brennanMKE/TronCostume/cad/params.md

# Frame parameters (mm)

Source: docs/frame.md. Origin = disc center. Angles clockwise from 12 o'clock seen from the front.
Bay local coords: y along the bay's center line from the disc center, x sideways (+ = clockwise).

| Name | Value |
|---|---|
| Outer radius | 130 |
| Hand hole radius | 60 |
| Outer rim inner radius | 114 |
| Ply layers | 4 × 6 (layers 1-3 identical, layer 4 adds wire slots) |
| Covered bays | centers 60° (buttons), 300° (electronics) |
| Covered bay front part | \|x\| ≤ 53, from the hand hole to y = 84 |
| Covered bay rear part | \|x\| ≤ 39, from y = 84 to R114 |
| Block pockets | x = ±39…±53, y = 64…84 (blocks 14 × 20 × 24) |
| Cover | 106 × 23.5 × 3 black acrylic, at y = 61…64, holes Ø4.5 at x = ±46 |
| Battery bay | center 180°, \|x\| ≤ 45, y = 66…96 |
| Front inserts | R102 at 0°, 120°, 240° |
| Back inserts | R80 at 0°, 120°, 240° |
| Insert OD (marked) | 8 |
| Wire slots (layer 4) | R92…R100, 320°→40° and 205°→278° |
