brennanMKE/TronCostume/concepts/Exploded DIY Tron identity disc.png

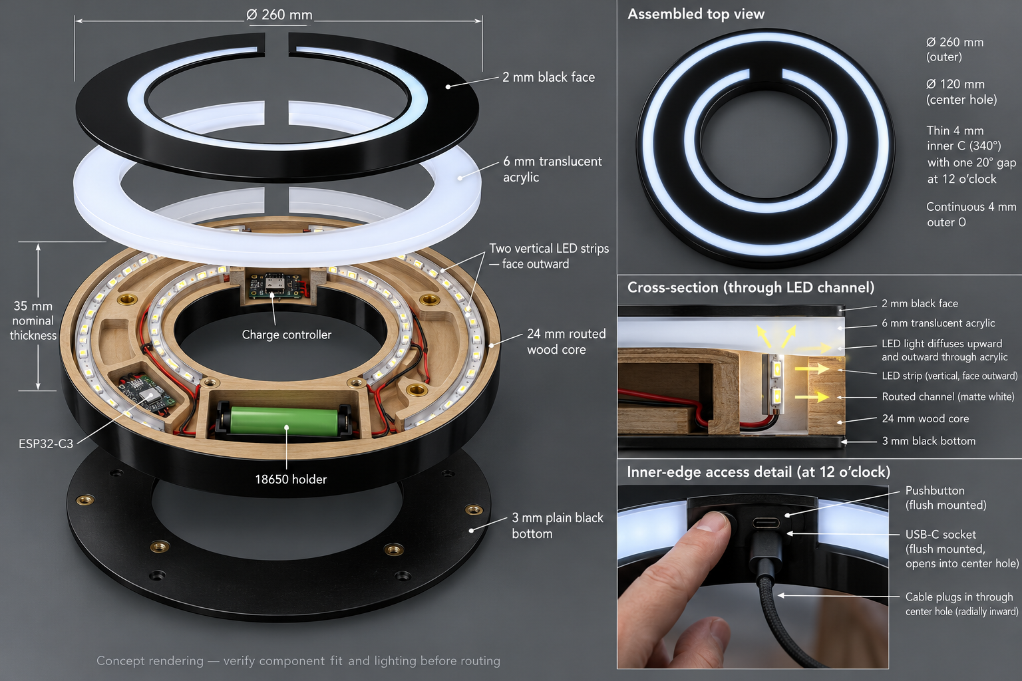
concepts/Exploded DIY Tron identity disc.png
