brennanMKE/TronCostume/concepts/Exploded vertical four-button plywood module.png

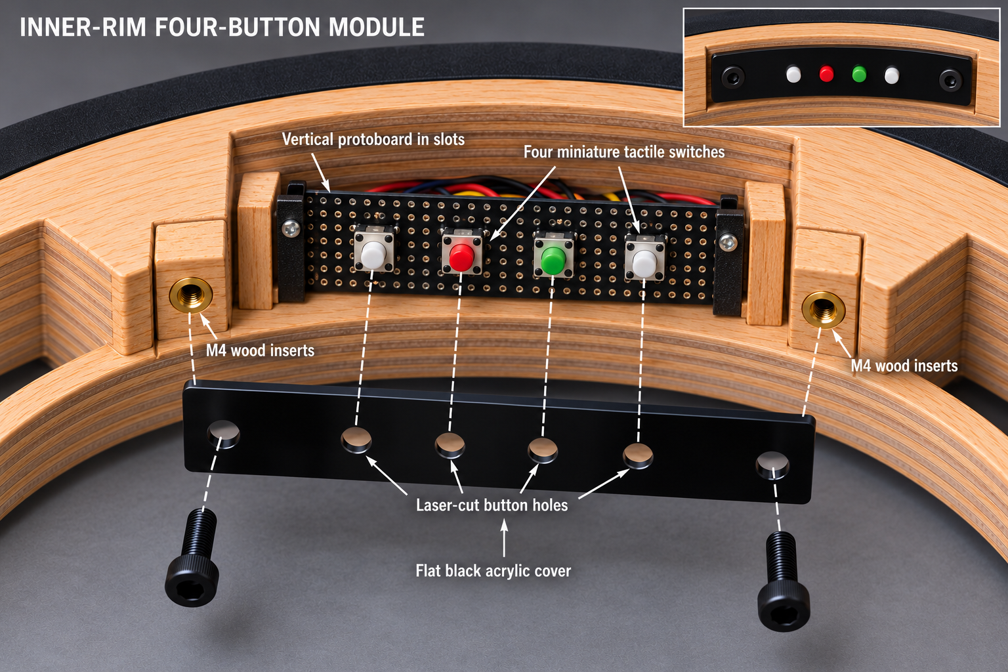
concepts/Exploded vertical four-button plywood module.png
