brennanMKE/TronCostume/concepts/Identity disc prototype.png

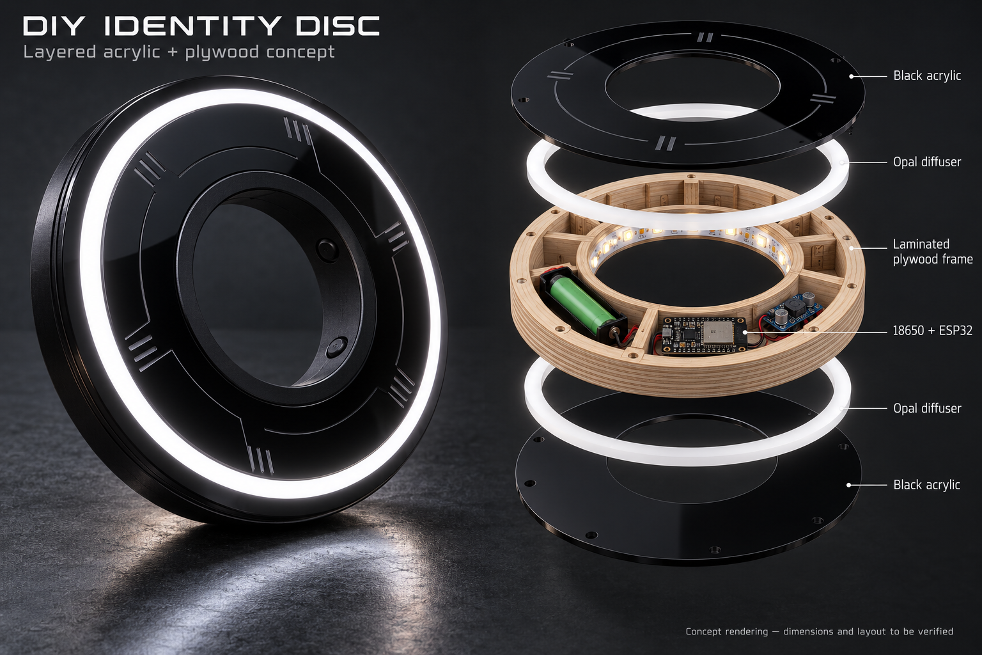
concepts/Identity disc prototype.png
