brennanMKE/TronCostume/concepts/Identity Disc.png

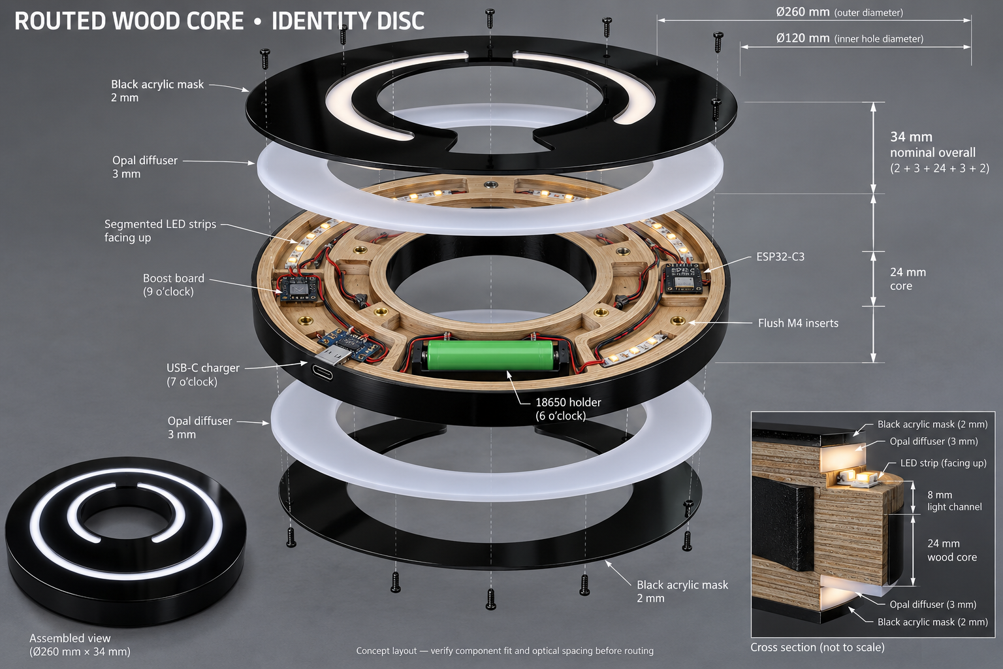
concepts/Identity Disc.png
