brennanMKE/TronCostume/concepts/Inner-rim electronics module.png

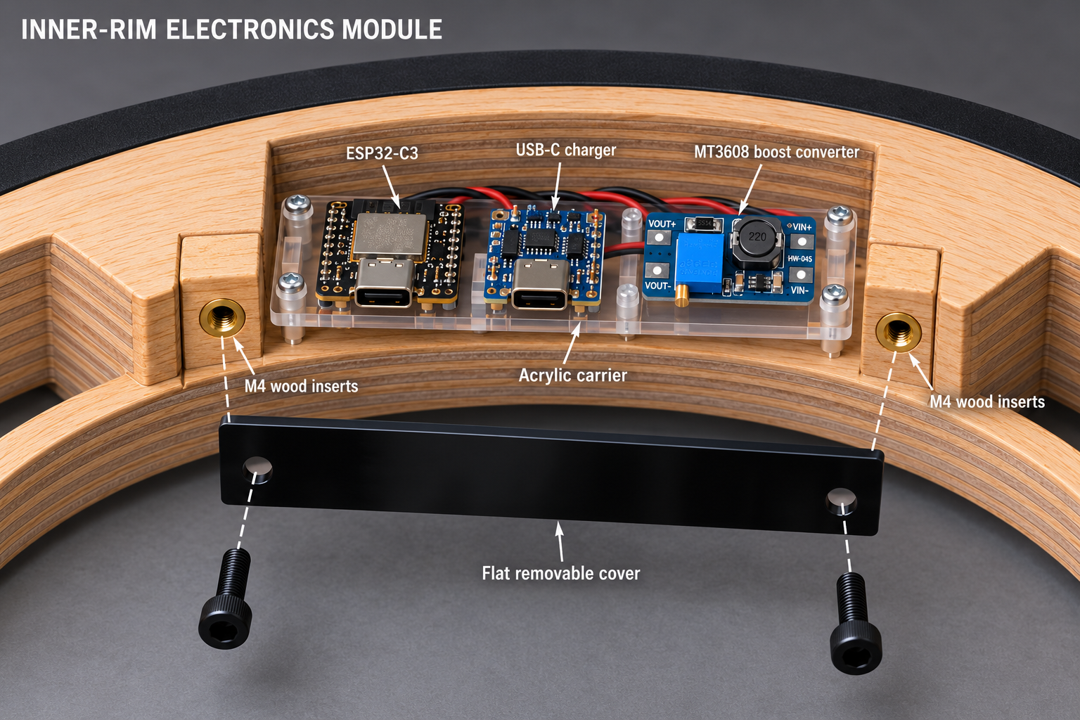
concepts/Inner-rim electronics module.png
