brennanMKE/TronCostume/concepts/Revised DIY Identity Disc Concept.png

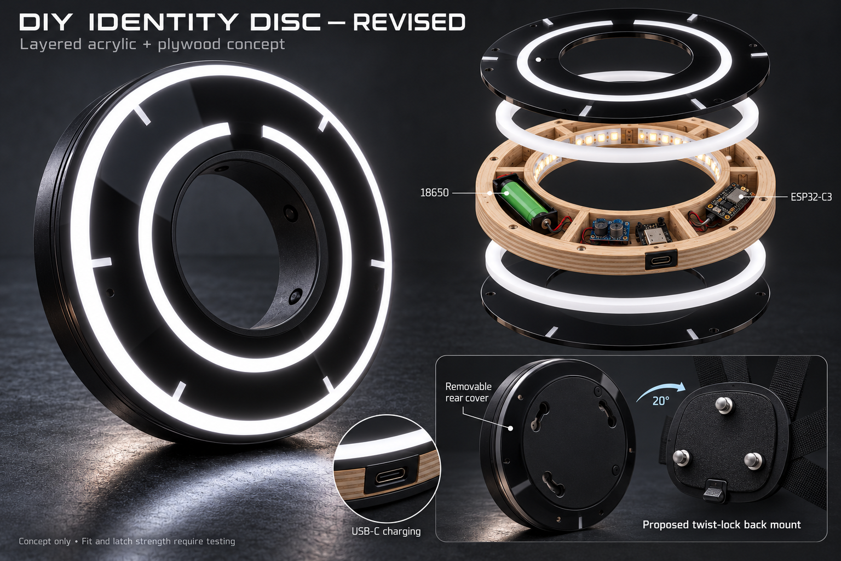
concepts/Revised DIY Identity Disc Concept.png
