brennanMKE/TronCostume/concepts/Three-bridge plywood annular frame.png

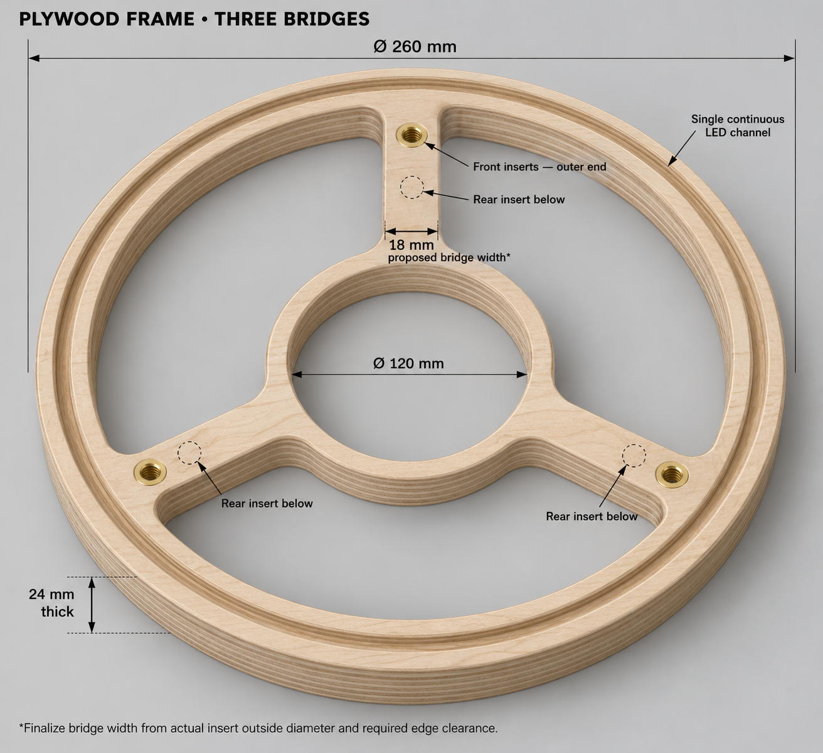
concepts/Three-bridge plywood annular frame.png
