brennanMKE/TronCostume/mockup/protoboard for buttons.png

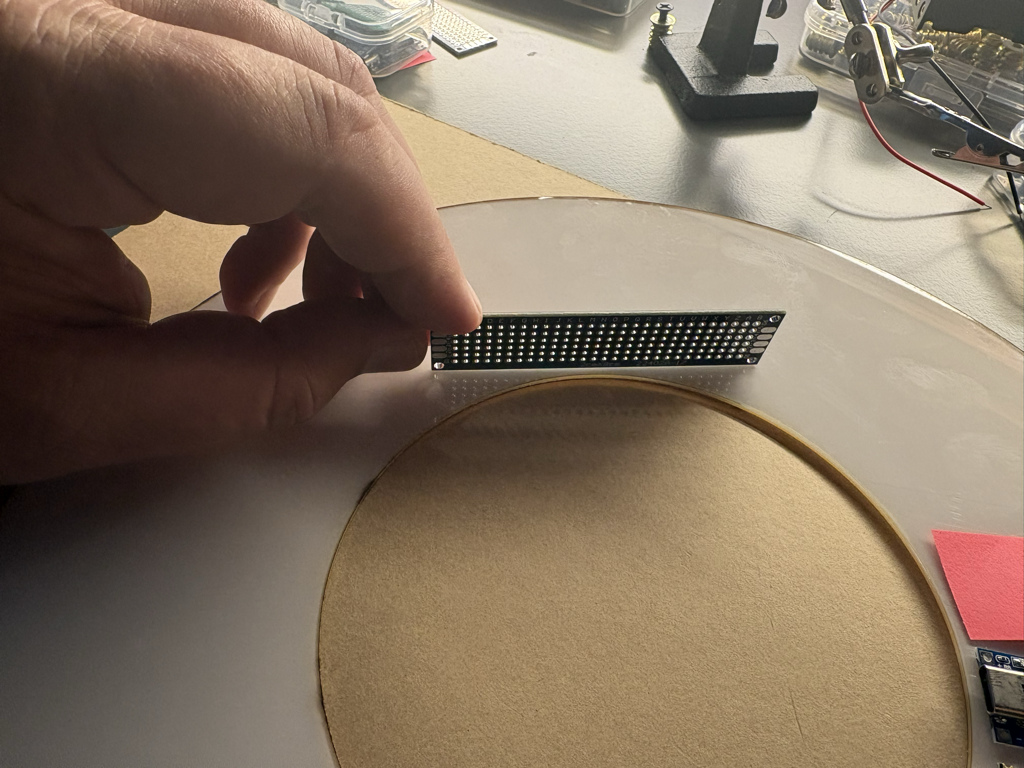
mockup/protoboard for buttons.png
