brennanMKE/TronCostume/build-plans/render/v4/PREVIEW-all-parts.png

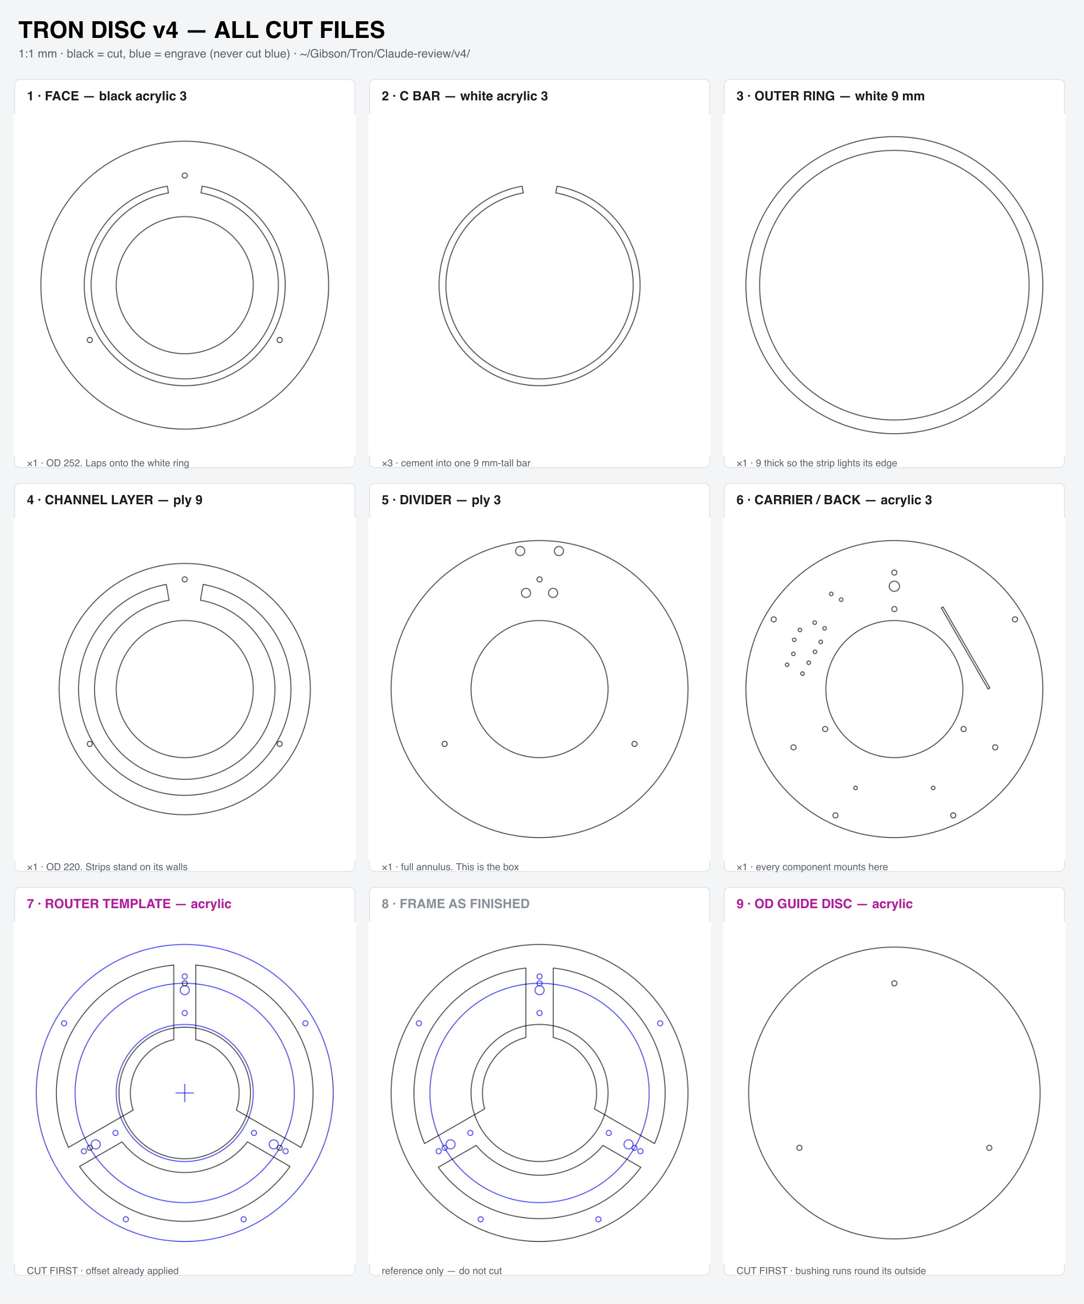
build-plans/render/v4/PREVIEW-all-parts.png
