brennanMKE/TronCostume/mockup/3 components.png

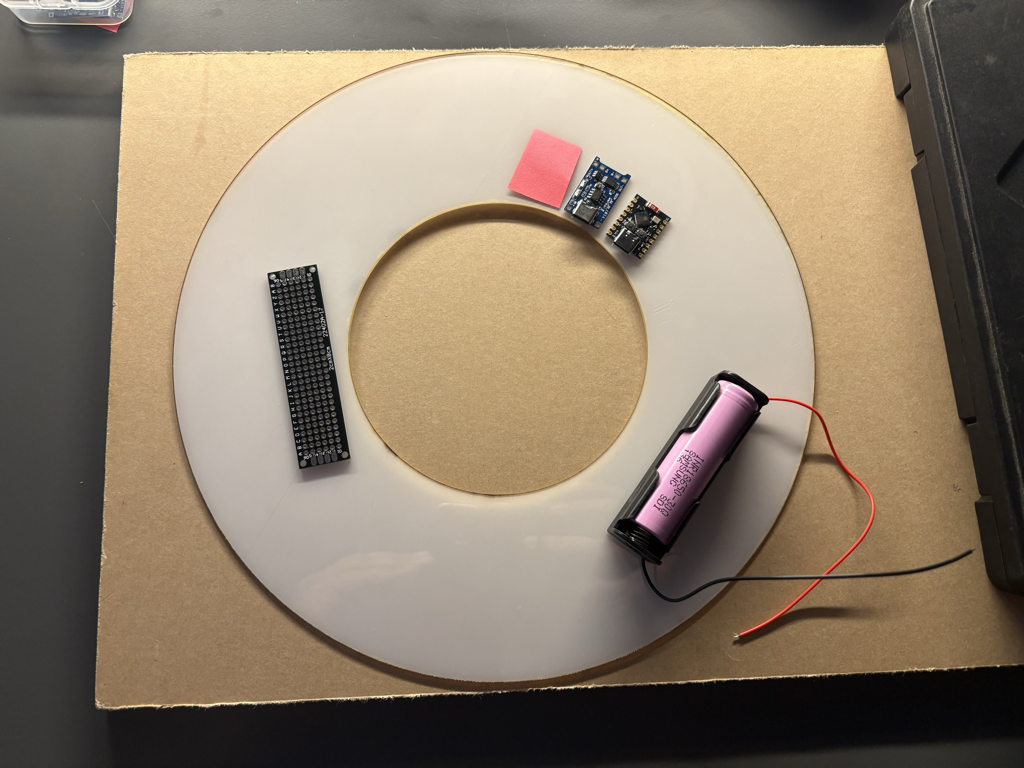
mockup/3 components.png
