brennanMKE/TronCostume/cad/v2/disc-v2-assembly.step

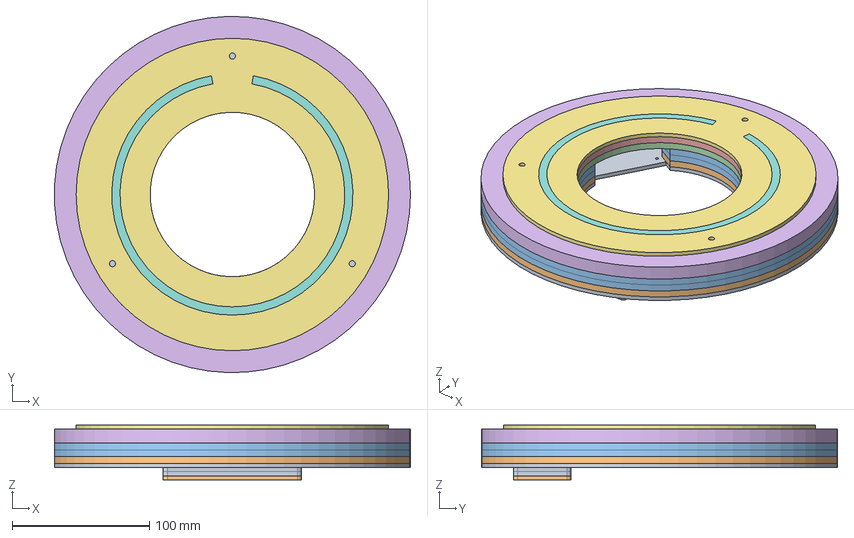
[picture p12: CAD file, 2026-11-05]
cad/v2/disc-v2-assembly.step
259.8 x 259.9 x 40.0 mm
