brennanMKE/TronCostume/cad/disc-assembly.step

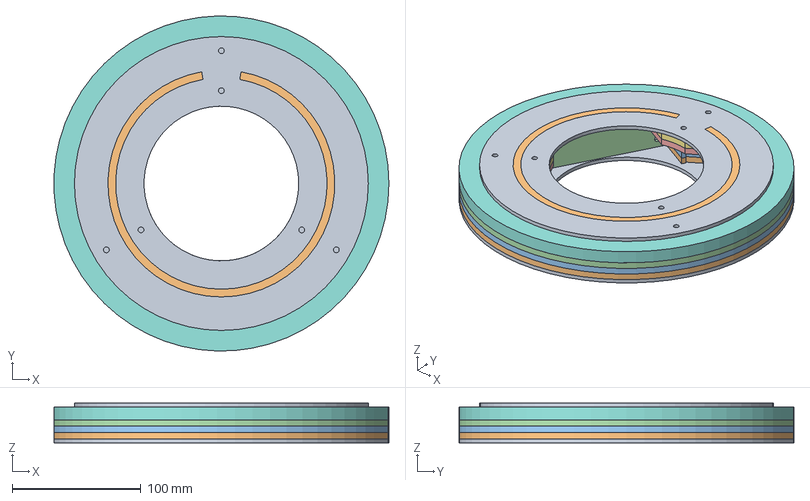
[picture p13: CAD file, 2026-11-05]
cad/disc-assembly.step
259.8 x 259.9 x 31.0 mm
