brennanMKE/TronCostume/cad/led-c-strip-reference.stl

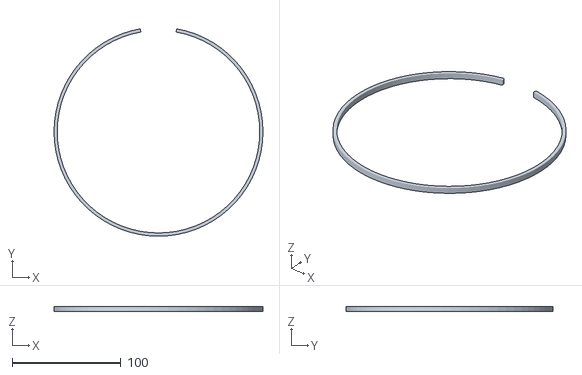
[picture p14: CAD file, 2026-11-05]
cad/led-c-strip-reference.stl
192.0 x 190.5 x 5.00
