brennanMKE/TronCostume/cad/out/frame.dxf

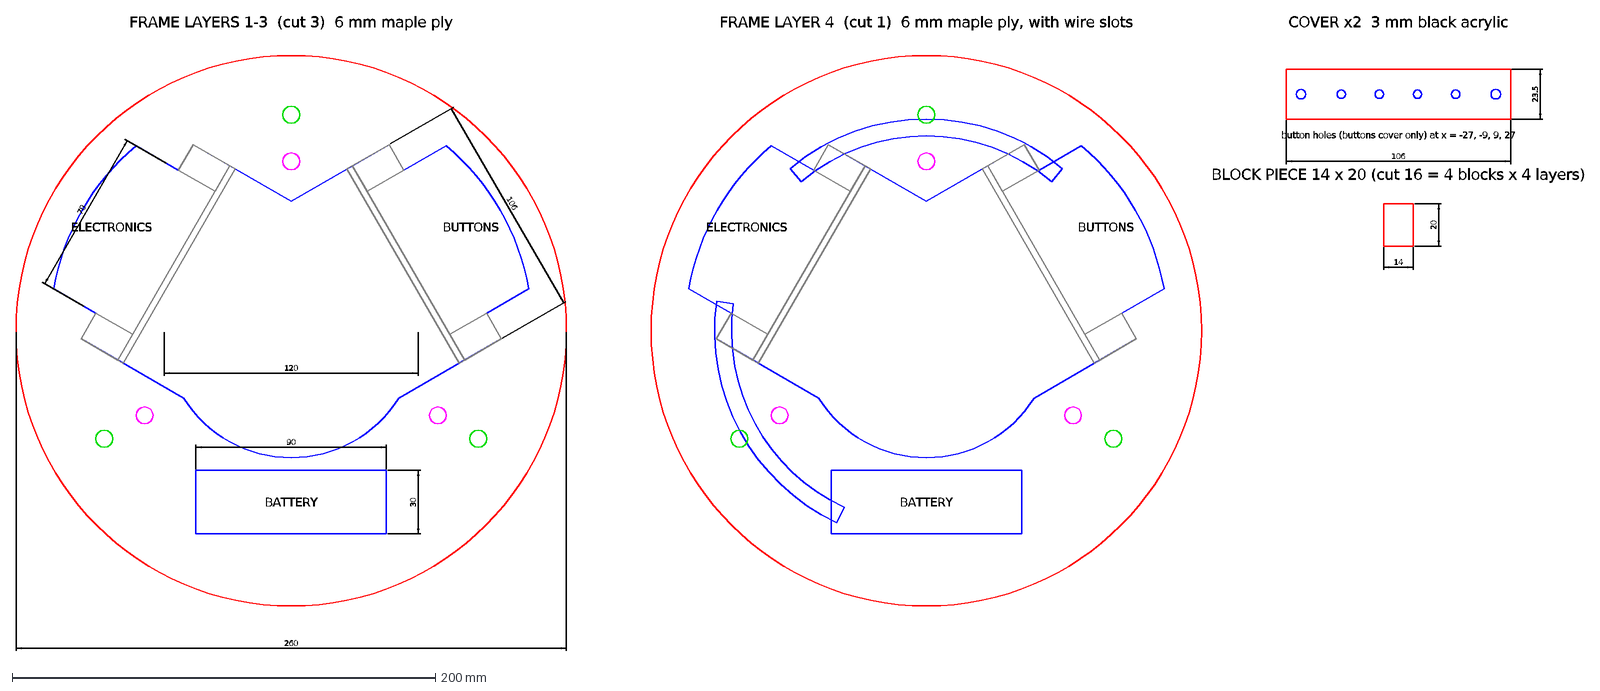
[picture p15: CAD file, 2026-10-30]
cad/out/frame.dxf
FRAME LAYERS 1-3 (cut 3) 6 mm maple ply
BUTTONS
ELECTRONICS
BATTERY
FRAME LAYER 4 (cut 1) 6 mm maple ply, with wire slots
COVER x2 3 mm black acrylic
button holes (buttons cover only) at x = -27, -9, 9, 27
BLOCK PIECE 14 x 20 (cut 16 = 4 blocks x 4 layers)
260
120
90
30
106
78
23.5
14
20
