brennanMKE/TronCostume/cad/v2/acrylic-3mm-black-back.dxf

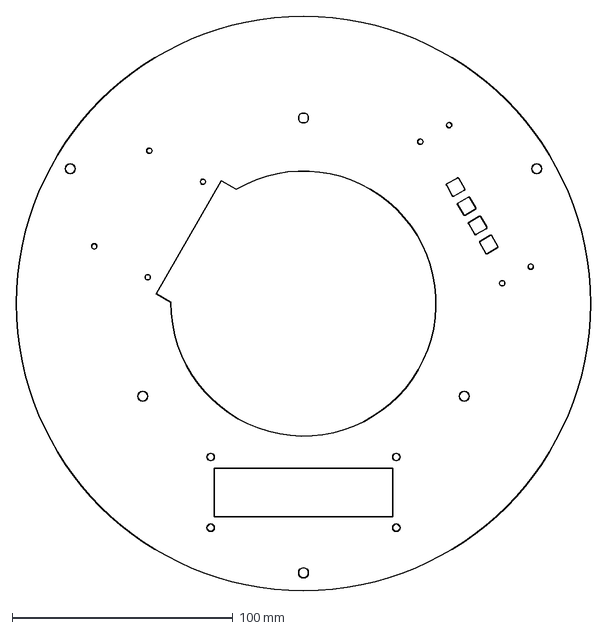
[picture p16: CAD file, 2026-11-05]
cad/v2/acrylic-3mm-black-back.dxf
260.0 x 260.0 mm
