brennanMKE/TronCostume/cad/v2/battery/stl/led_piece.stl

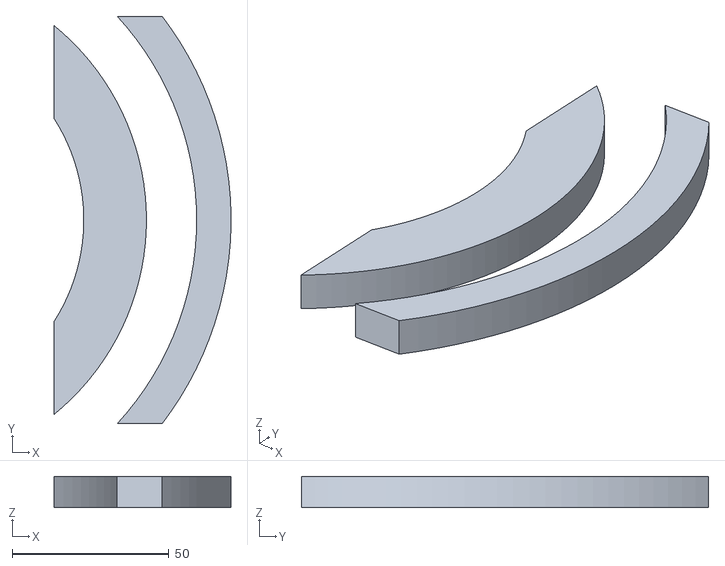
[picture p17: CAD file, 2026-11-05]
cad/v2/battery/stl/led_piece.stl
56.5 x 130.0 x 10.0
