brennanMKE/TronCostume/cad/v2/pod/stl/ics.stl

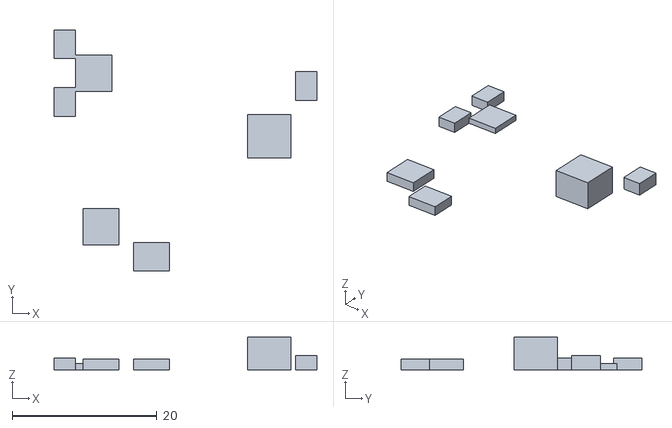
[picture p18: CAD file, 2026-11-05]
cad/v2/pod/stl/ics.stl
36.4 x 33.4 x 4.50
