brennanMKE/TronCostume/cad/v2/stl/inserts_ref.stl

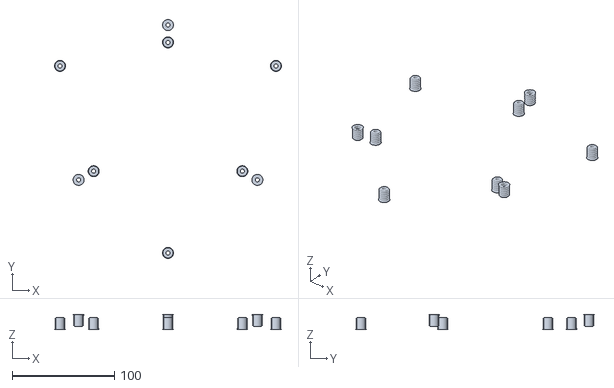
[picture p19: CAD file, 2026-11-05]
cad/v2/stl/inserts_ref.stl
222.1 x 233.8 x 15.0
