brennanMKE/TronCostume/cad/led-connector-reference.stl

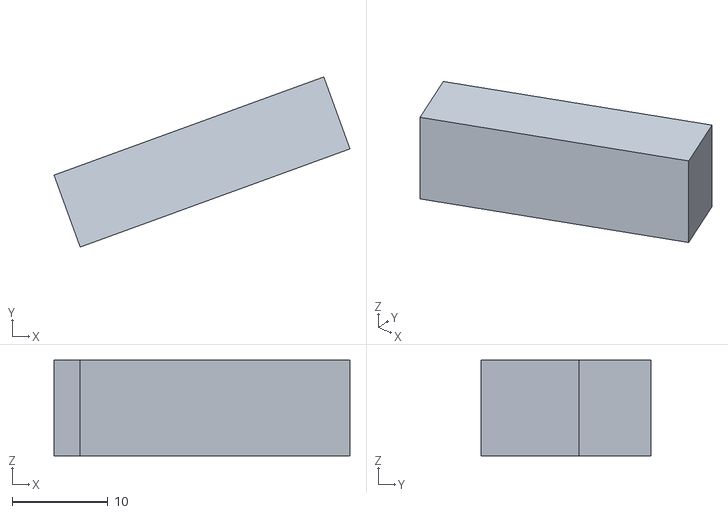
[picture p20: CAD file, 2026-11-05]
cad/led-connector-reference.stl
30.9 x 17.8 x 10.0
