brennanMKE/TronCostume/cad/v2/pod/stl/led_piece.stl

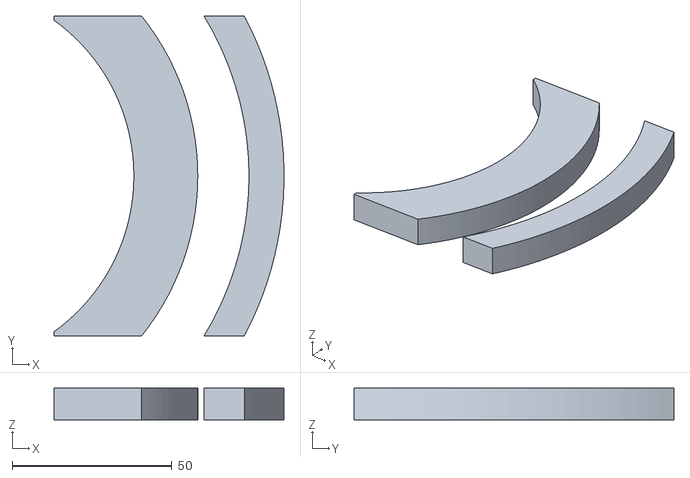
[picture p21: CAD file, 2026-11-05]
cad/v2/pod/stl/led_piece.stl
72.0 x 100.0 x 10.0
