brennanMKE/TronCostume/cad/v2/stl/led_jumper.stl

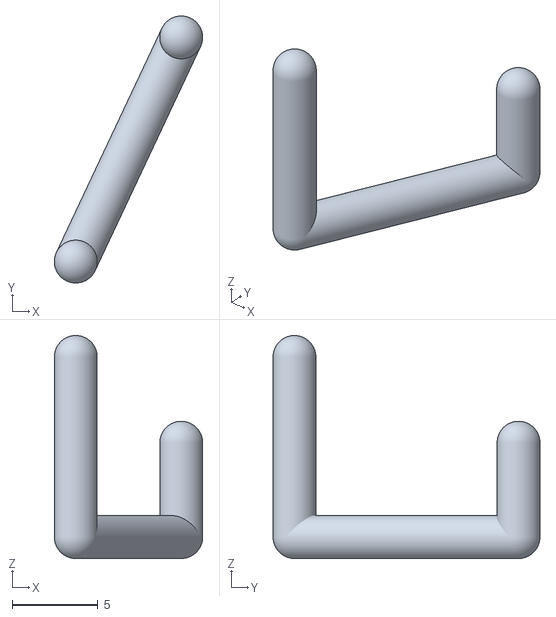
[picture p22: CAD file, 2026-11-05]
cad/v2/stl/led_jumper.stl
8.65 x 15.6 x 13.0
