brennanMKE/TronCostume/cad/acrylic-10mm-white-outer-ring.step

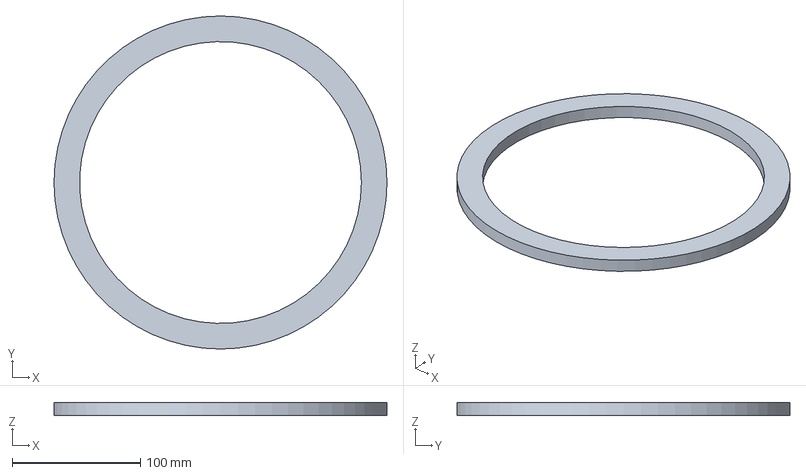
[picture p23: CAD file, 2026-11-05]
cad/acrylic-10mm-white-outer-ring.step
260.0 x 260.0 x 10.0 mm
