brennanMKE/TronCostume/cad/v2/acrylic-3mm-black-battery-box-floor.dxf

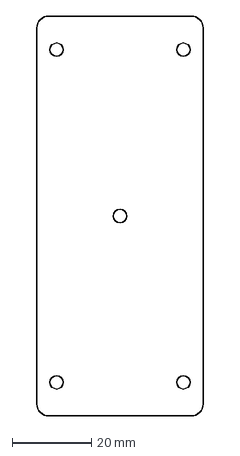
[picture p24: CAD file, 2026-11-05]
cad/v2/acrylic-3mm-black-battery-box-floor.dxf
42.0 x 101.0 mm
