brennanMKE/TronCostume/cad/v2/battery/stl/ring2.stl

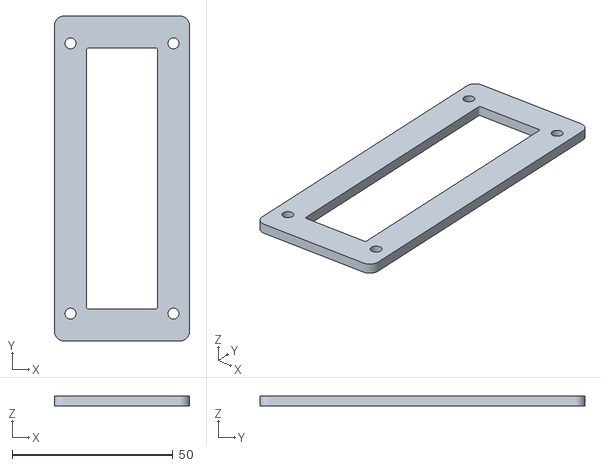
[picture p25: CAD file, 2026-11-05]
cad/v2/battery/stl/ring2.stl
42.0 x 101.0 x 3.00
