brennanMKE/TronCostume/cad/v2/pod/stl/locator.stl

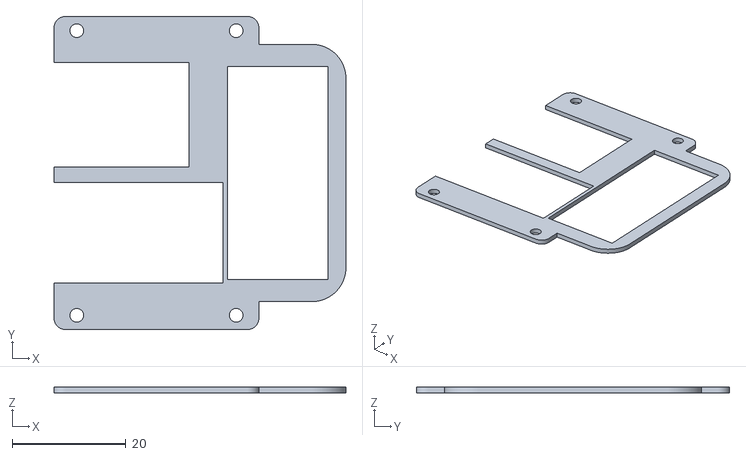
[picture p26: CAD file, 2026-11-05]
cad/v2/pod/stl/locator.stl
51.3 x 55.0 x 1.00
