brennanMKE/TronCostume/cad/disc-lid.step

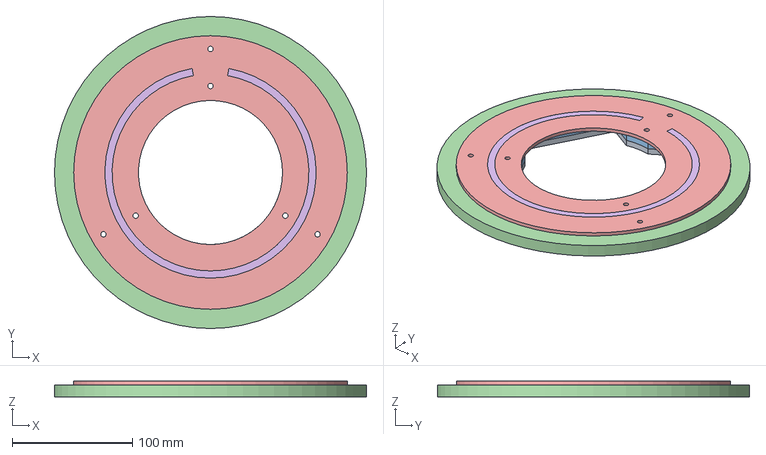
[picture p27: CAD file, 2026-11-05]
cad/disc-lid.step
260.0 x 260.0 x 13.0 mm
