brennanMKE/TronCostume/cad/v2/battery/stl/frame_piece.stl

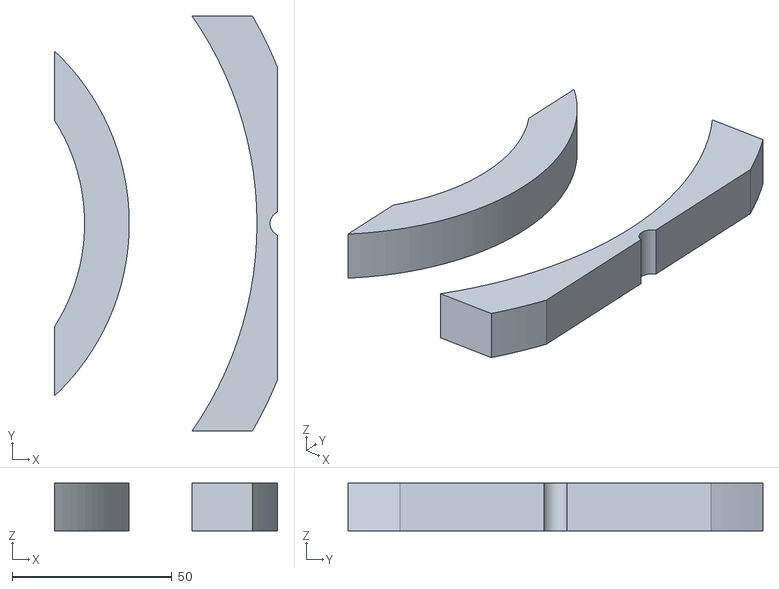
[picture p28: CAD file, 2026-11-05]
cad/v2/battery/stl/frame_piece.stl
70.0 x 130.0 x 15.0
