brennanMKE/TronCostume/cad/v2/pod/stl/pcb_blue.stl

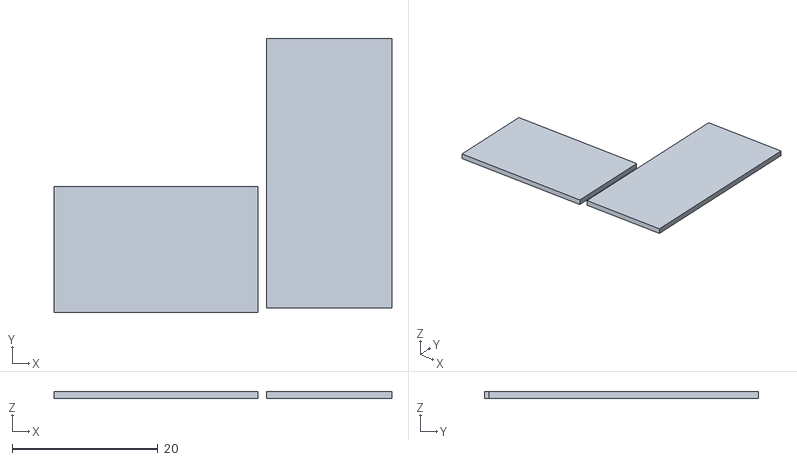
[picture p30: CAD file, 2026-11-05]
cad/v2/pod/stl/pcb_blue.stl
46.4 x 37.6 x 1.00
