brennanMKE/TronCostume/cad/v2/stl/pod_hardware.stl

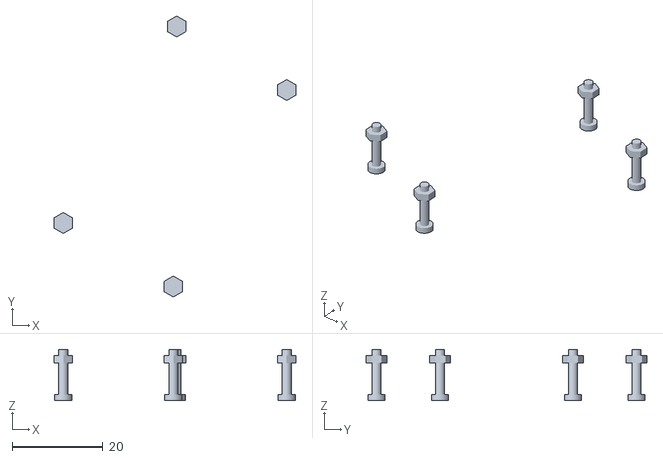
[picture p31: CAD file, 2026-11-05]
cad/v2/stl/pod_hardware.stl
53.2 x 61.9 x 11.3
