brennanMKE/TronCostume/cad/acrylic-3mm-black-face.step

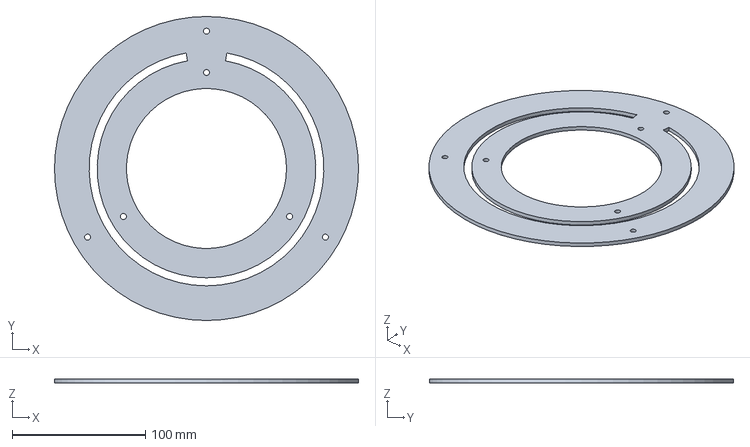
[picture p32: CAD file, 2026-11-05]
cad/acrylic-3mm-black-face.step
228.0 x 228.0 x 3.00 mm
