brennanMKE/TronCostume/cad/v2/battery/stl/back_piece.stl

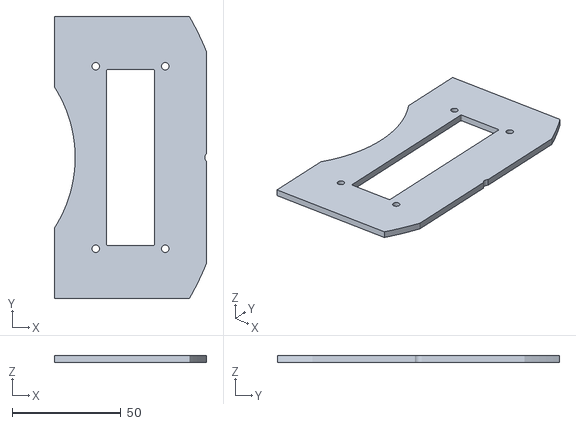
[picture p33: CAD file, 2026-11-05]
cad/v2/battery/stl/back_piece.stl
70.0 x 130.0 x 3.00
