brennanMKE/TronCostume/cad/v2/maple-5mm-frame3.dxf

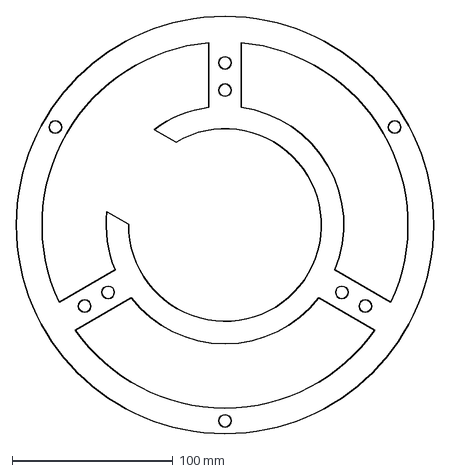
[picture p34: CAD file, 2026-11-05]
cad/v2/maple-5mm-frame3.dxf
260.0 x 260.0 mm
