brennanMKE/TronCostume/cad/v2/pod/stl/holddown.stl

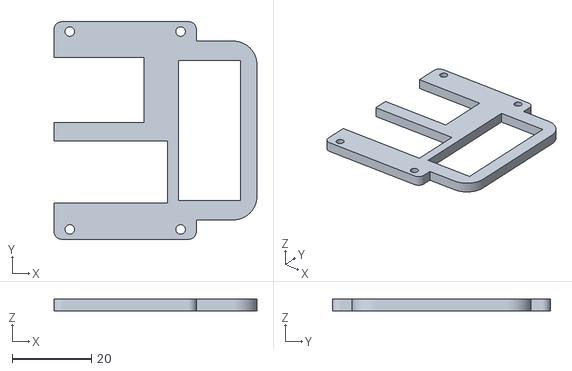
[picture p35: CAD file, 2026-11-05]
cad/v2/pod/stl/holddown.stl
51.3 x 55.0 x 3.00
