brennanMKE/TronCostume/cad/v2/stl/led_wire_pod.stl

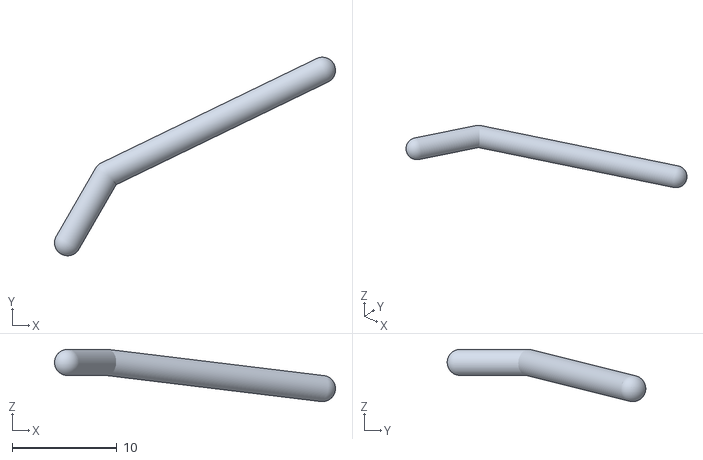
[picture p36: CAD file, 2026-11-05]
cad/v2/stl/led_wire_pod.stl
26.8 x 19.0 x 5.00
