brennanMKE/TronCostume/cad/insert-blocks-reference.stl

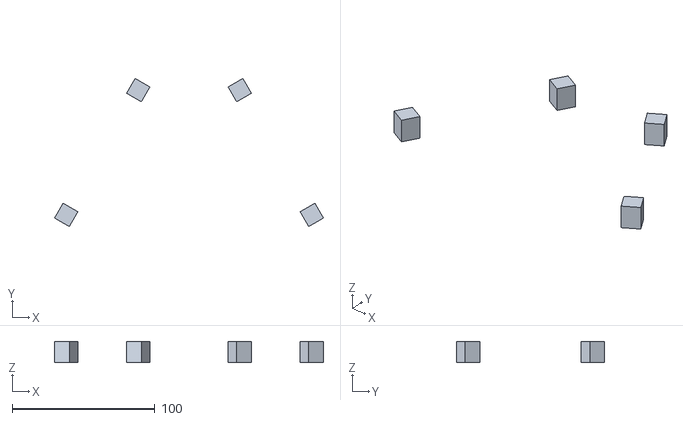
[picture p37: CAD file, 2026-11-05]
cad/insert-blocks-reference.stl
188.6 x 103.9 x 15.0
