brennanMKE/TronCostume/cad/v2/acrylic-thin-pod-locator.dxf

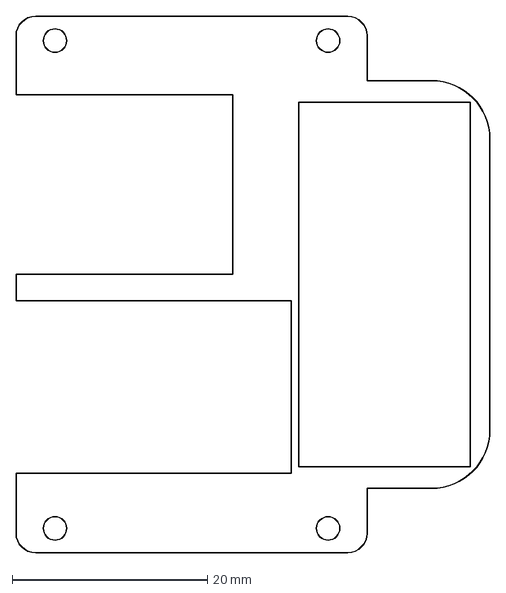
[picture p38: CAD file, 2026-11-05]
cad/v2/acrylic-thin-pod-locator.dxf
48.6 x 55.0 mm
