brennanMKE/TronCostume/cad/v2/battery/stl/holder.stl

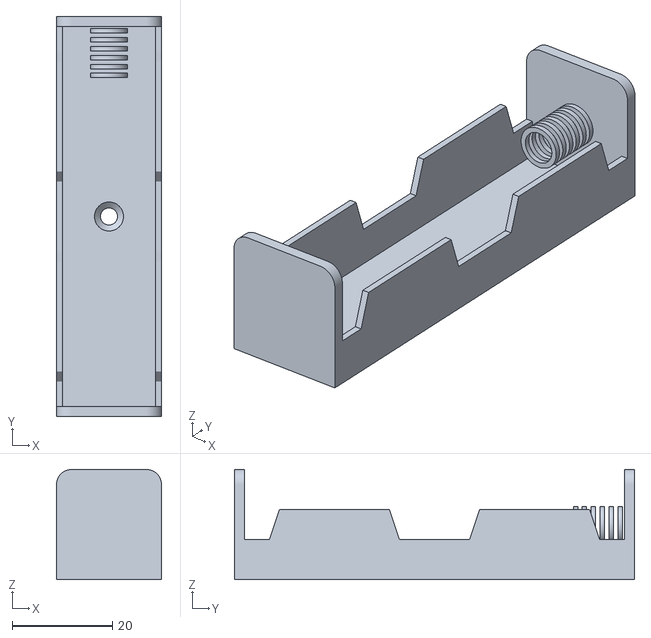
[picture p39: CAD file, 2026-11-05]
cad/v2/battery/stl/holder.stl
21.0 x 80.0 x 22.0
