brennanMKE/TronCostume/cad/v2/pod/stl/metal.stl

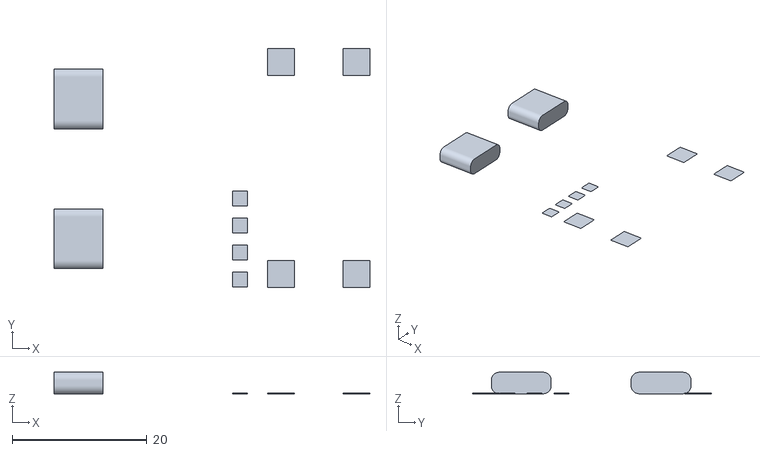
[picture p40: CAD file, 2026-11-05]
cad/v2/pod/stl/metal.stl
46.9 x 35.4 x 3.20
