brennanMKE/TronCostume/cad/v2/stl/frame2.stl

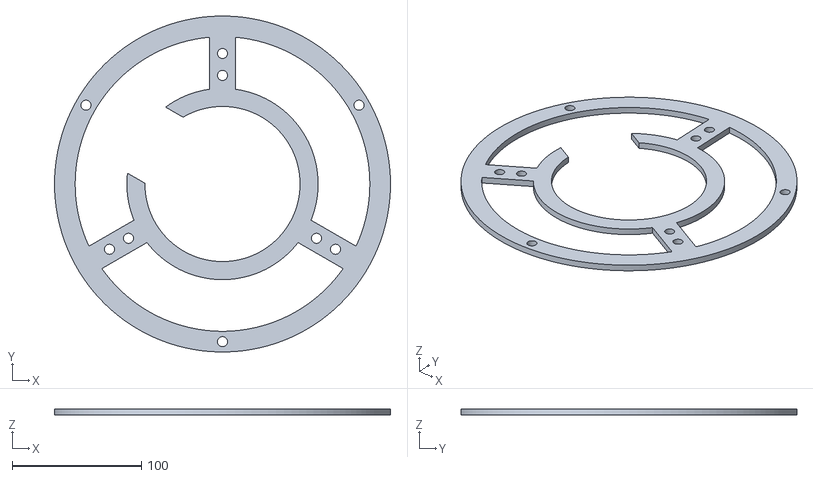
[picture p41: CAD file, 2026-11-05]
cad/v2/stl/frame2.stl
260.0 x 259.9 x 5.00
