brennanMKE/TronCostume/cad/acrylic-3mm-white-c.step

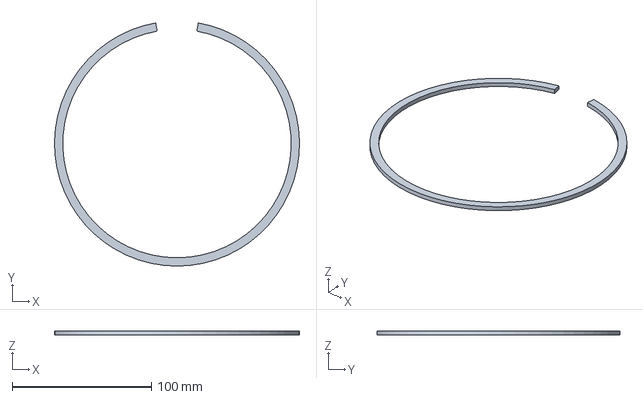
[picture p42: CAD file, 2026-11-05]
cad/acrylic-3mm-white-c.step
176.0 x 174.7 x 3.00 mm
