brennanMKE/TronCostume/cad/v2/acrylic-3mm-white-c.dxf

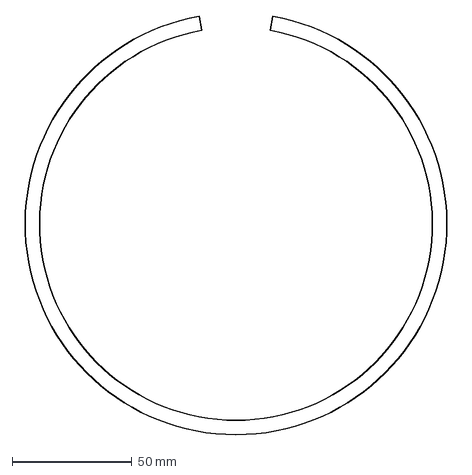
[picture p43: CAD file, 2026-11-05]
cad/v2/acrylic-3mm-white-c.dxf
183.3 x 174.7 mm
