brennanMKE/TronCostume/cad/v2/battery/stl/cell.stl

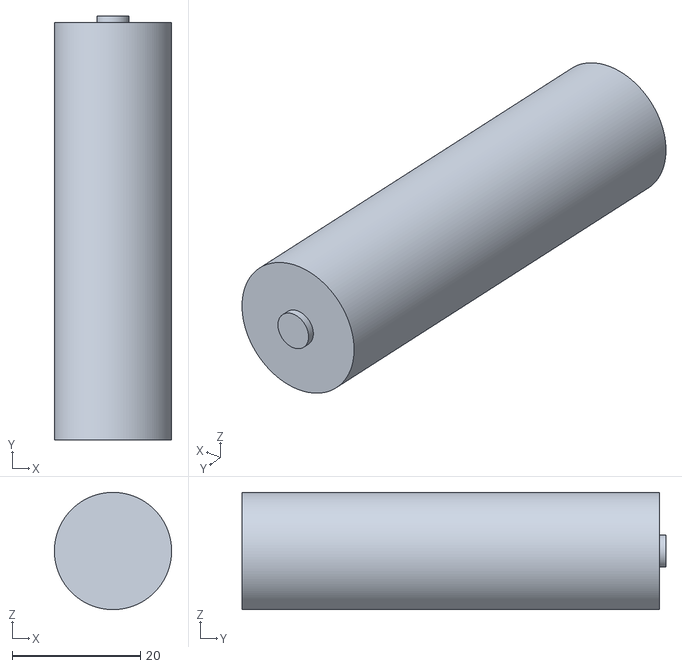
[picture p44: CAD file, 2026-11-05]
cad/v2/battery/stl/cell.stl
18.3 x 66.2 x 18.3
