brennanMKE/TronCostume/cad/v2/pod/stl/back_piece.stl

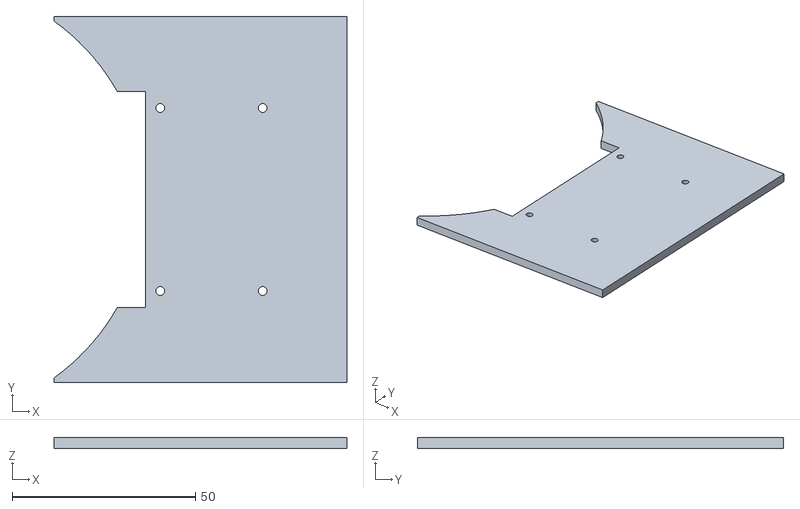
[picture p45: CAD file, 2026-11-05]
cad/v2/pod/stl/back_piece.stl
80.0 x 100.0 x 3.00
