brennanMKE/TronCostume/cad/v2/stl/led1.stl

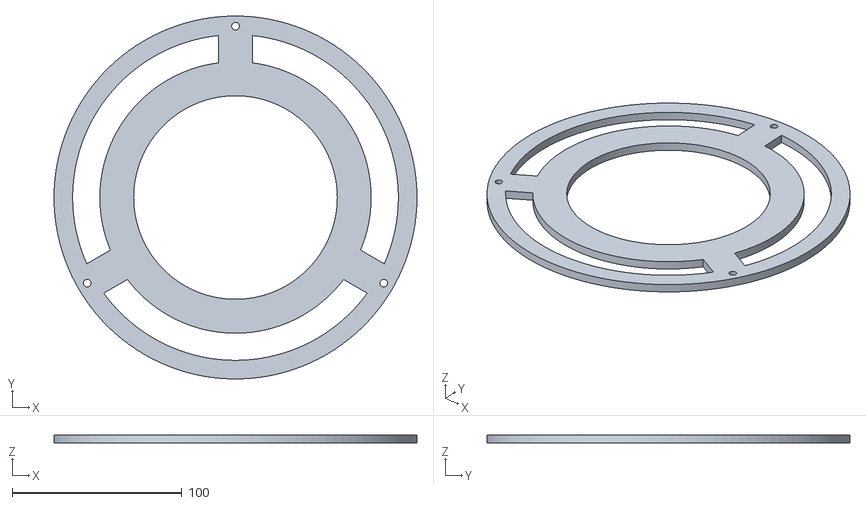
[picture p46: CAD file, 2026-11-05]
cad/v2/stl/led1.stl
214.0 x 213.9 x 5.00
