brennanMKE/TronCostume/cad/v2/acrylic-3mm-black-pod-holddown.dxf

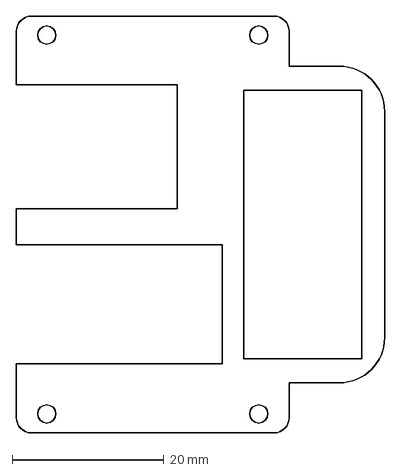
[picture p47: CAD file, 2026-11-05]
cad/v2/acrylic-3mm-black-pod-holddown.dxf
48.6 x 55.0 mm
