brennanMKE/TronCostume/cad/v2/pod/stl/frame_piece.stl

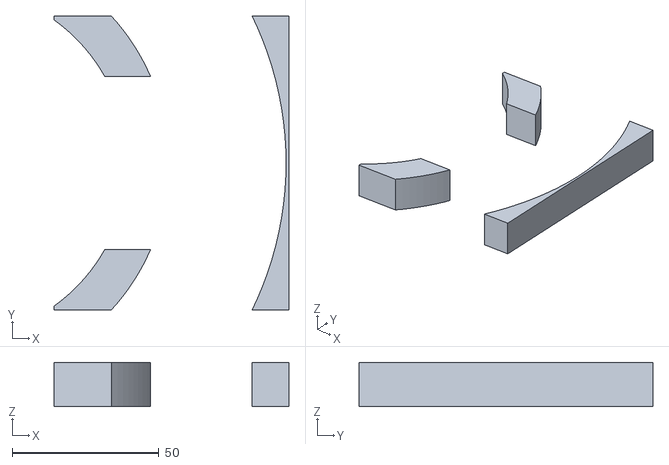
[picture p48: CAD file, 2026-11-05]
cad/v2/pod/stl/frame_piece.stl
80.0 x 100.0 x 15.0
