brennanMKE/TronCostume/cad/v2/stl/back.stl

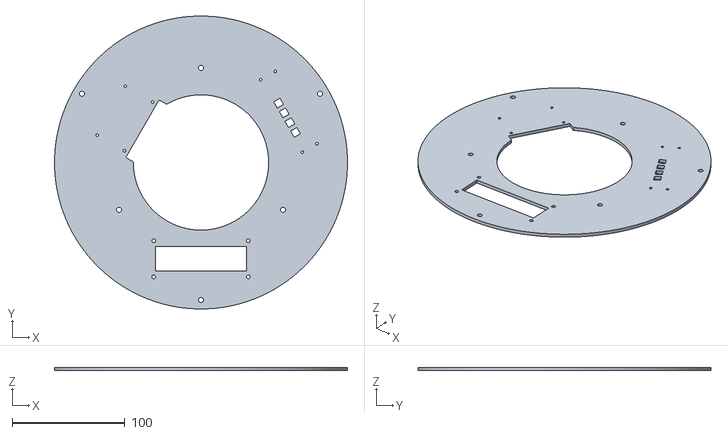
[picture p49: CAD file, 2026-11-05]
cad/v2/stl/back.stl
260.0 x 259.9 x 3.00
