brennanMKE/TronCostume/cad/led-outer-strip-reference.stl

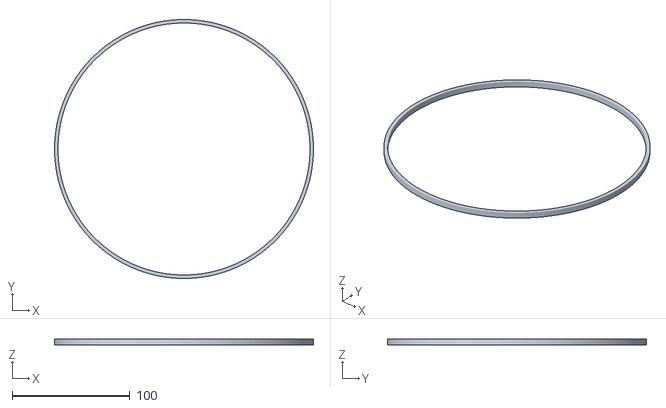
[picture p50: CAD file, 2026-11-05]
cad/led-outer-strip-reference.stl
220.0 x 219.9 x 5.00
