brennanMKE/TronCostume/cad/v2/acrylic-10mm-white-ring.dxf

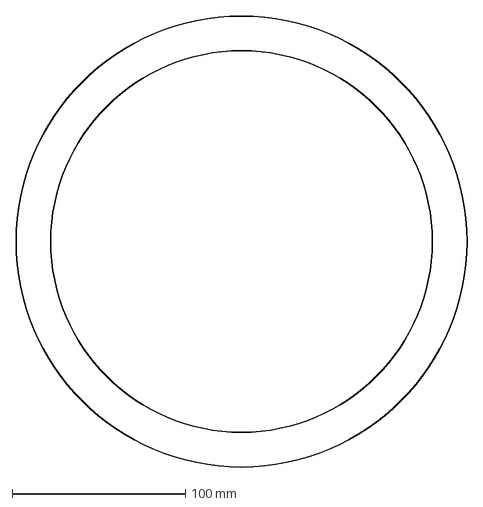
[picture p51: CAD file, 2026-11-05]
cad/v2/acrylic-10mm-white-ring.dxf
260.0 x 260.0 mm
