brennanMKE/TronCostume/cad/v2/pod/stl/plugs.stl

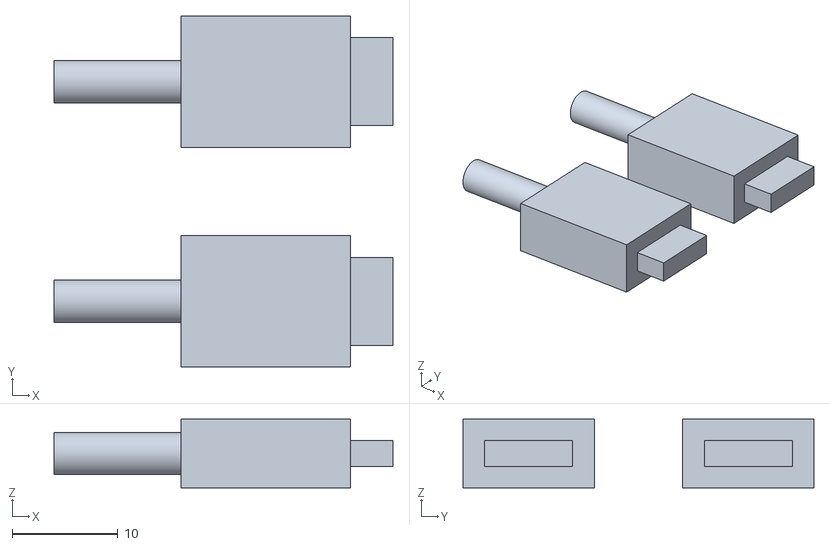
[picture p53: CAD file, 2026-11-05]
cad/v2/pod/stl/plugs.stl
32.0 x 33.2 x 6.50
