brennanMKE/TronCostume/cad/v2/stl/pod_holddown.stl

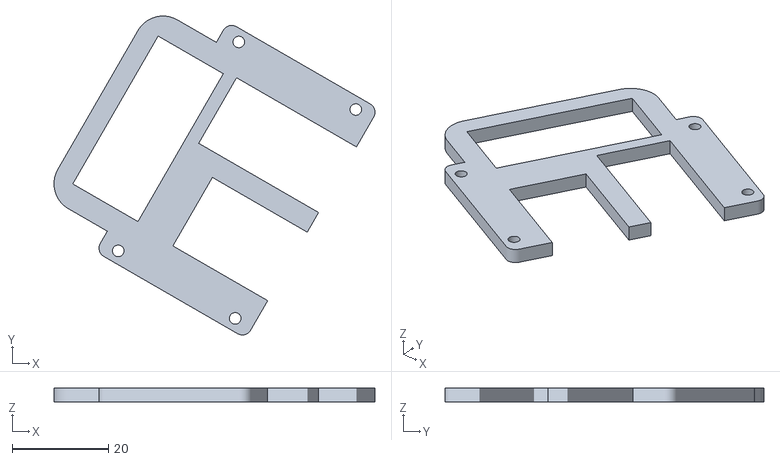
[picture p54: CAD file, 2026-11-05]
cad/v2/stl/pod_holddown.stl
66.5 x 66.1 x 3.00
