brennanMKE/TronCostume/cad/v2/acrylic-3mm-black-pod-face-plate.dxf

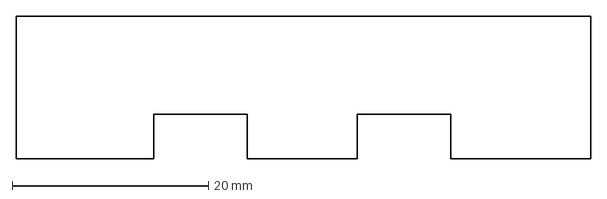
[picture p55: CAD file, 2026-11-05]
cad/v2/acrylic-3mm-black-pod-face-plate.dxf
58.5 x 14.5 mm
