brennanMKE/TronCostume/cad/v2/pod/stl/trimpot.stl

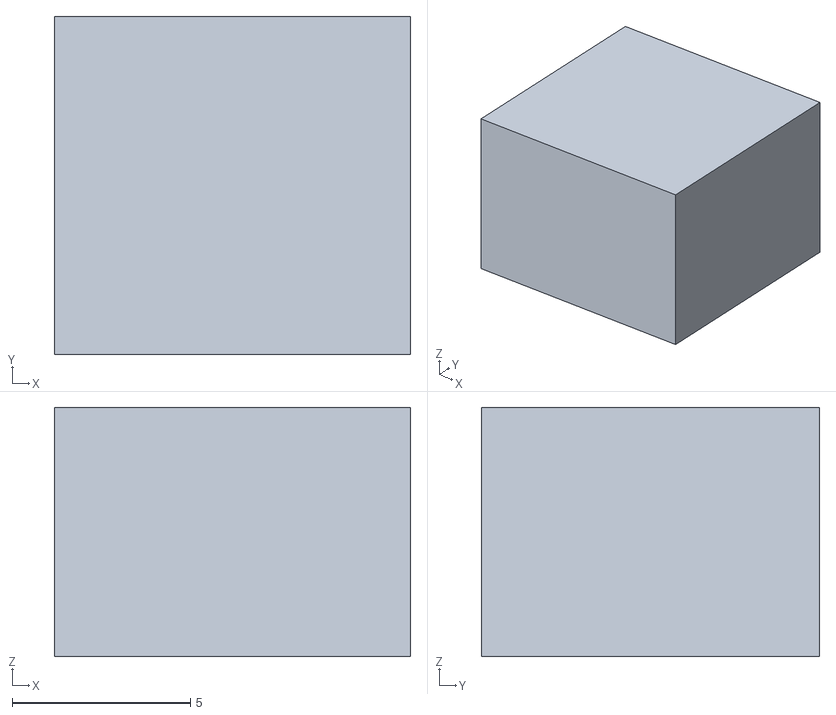
[picture p56: CAD file, 2026-11-05]
cad/v2/pod/stl/trimpot.stl
10.0 x 9.50 x 7.00
