brennanMKE/TronCostume/cad/acrylic-3mm-cover-usb.step

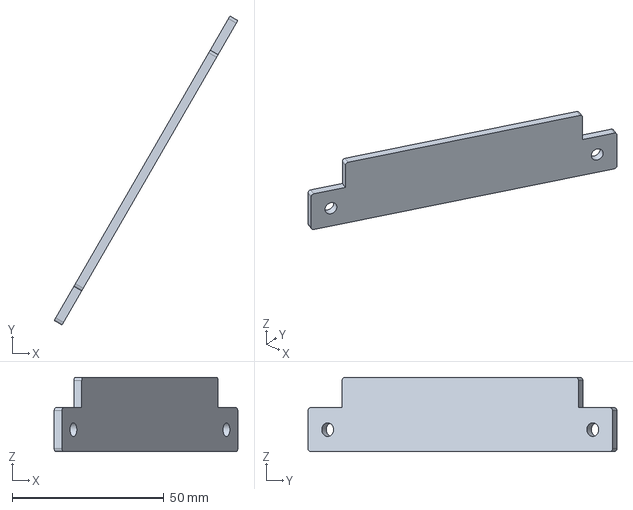
[picture p57: CAD file, 2026-11-05]
cad/acrylic-3mm-cover-usb.step
60.6 x 102.0 x 24.5 mm
