brennanMKE/TronCostume/cad/v2/acrylic-3mm-black-battery-box-ring-x2.dxf

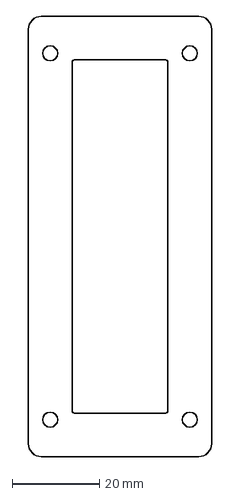
[picture p58: CAD file, 2026-11-05]
cad/v2/acrylic-3mm-black-battery-box-ring-x2.dxf
42.0 x 101.0 mm
