brennanMKE/TronCostume/cad/v2/pod/stl/pcb_black.stl

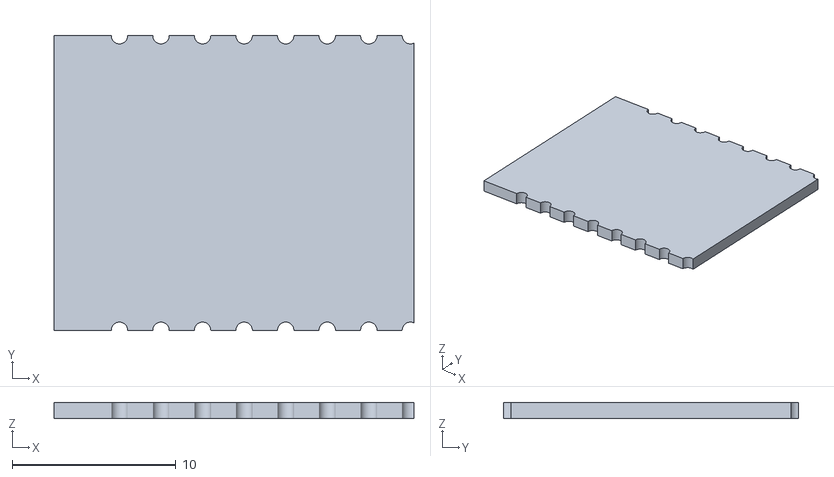
[picture p59: CAD file, 2026-11-05]
cad/v2/pod/stl/pcb_black.stl
22.0 x 18.0 x 1.00
