brennanMKE/TronCostume/cad/maple-5mm-layer3.step

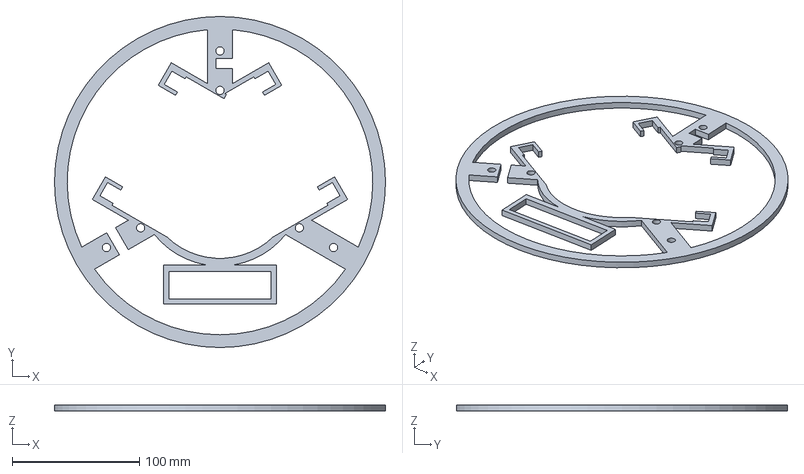
[picture p60: CAD file, 2026-11-05]
cad/maple-5mm-layer3.step
260.0 x 260.0 x 5.00 mm
