brennanMKE/TronCostume/cad/v2/maple-5mm-frame2.dxf

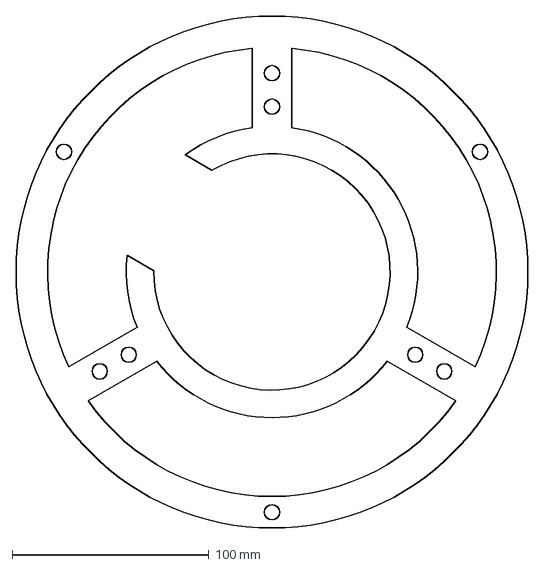
[picture p61: CAD file, 2026-11-05]
cad/v2/maple-5mm-frame2.dxf
260.0 x 260.0 mm
