brennanMKE/TronCostume/cad/v2/pod/stl/hardware.stl

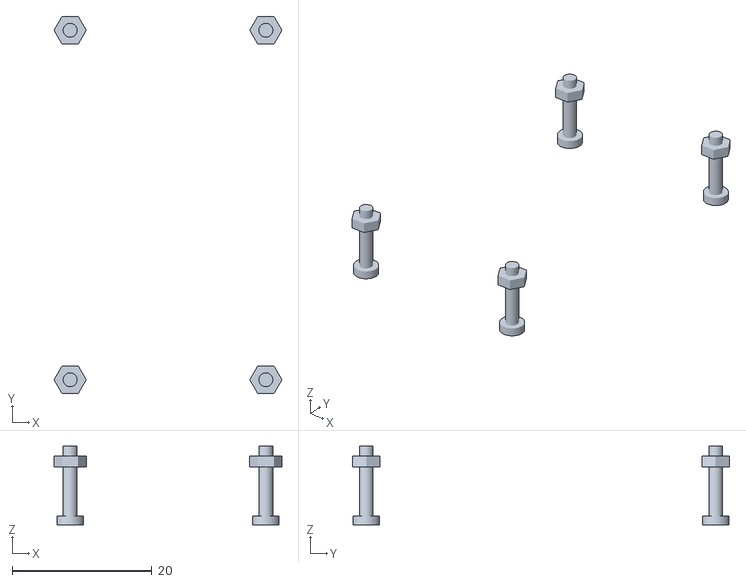
[picture p62: CAD file, 2026-11-05]
cad/v2/pod/stl/hardware.stl
32.6 x 54.0 x 11.3
