brennanMKE/TronCostume/cad/v2/stl/led_connector.stl

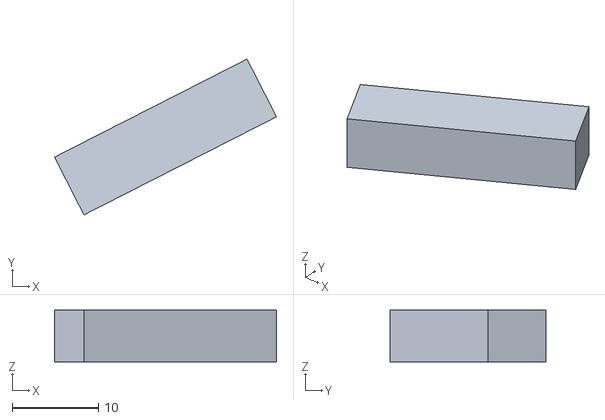
[picture p63: CAD file, 2026-11-05]
cad/v2/stl/led_connector.stl
25.7 x 18.0 x 6.00
