brennanMKE/TronCostume/cad/maple-5mm-layer5.step

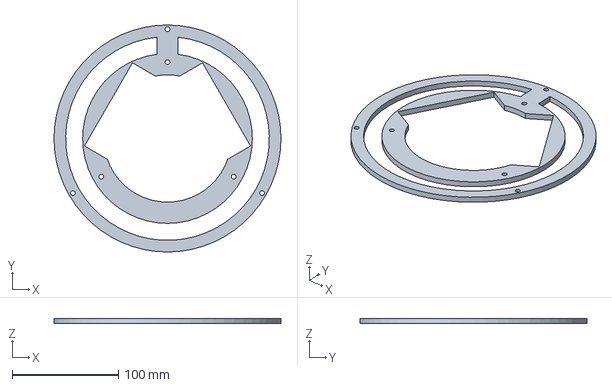
[picture p64: CAD file, 2026-11-05]
cad/maple-5mm-layer5.step
214.0 x 214.0 x 5.00 mm
