brennanMKE/TronCostume/cad/v2/acrylic-3mm-black-face.dxf

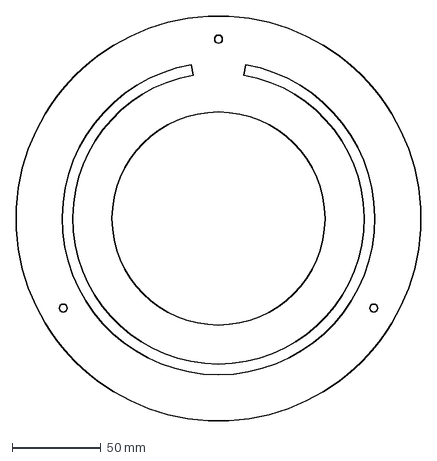
[picture p65: CAD file, 2026-11-05]
cad/v2/acrylic-3mm-black-face.dxf
228.0 x 228.0 mm
