brennanMKE/TronCostume/cad/v2/stl/pod_metal.stl

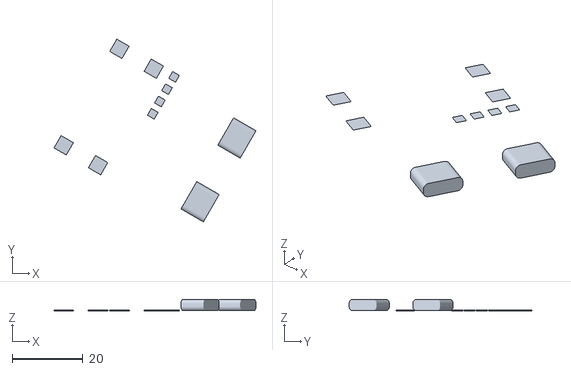
[picture p66: CAD file, 2026-11-05]
cad/v2/stl/pod_metal.stl
56.9 x 51.5 x 3.20
