brennanMKE/TronCostume/cad/v2/maple-5mm-insert-test-coupon.dxf

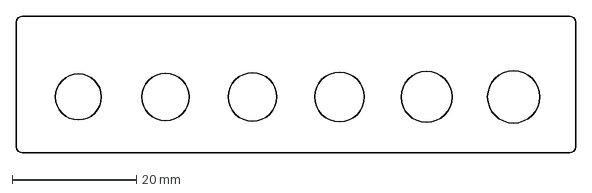
[picture p67: CAD file, 2026-11-05]
cad/v2/maple-5mm-insert-test-coupon.dxf
90.0 x 22.0 mm
