brennanMKE/TronCostume/cad/v2/maple-5mm-led2.dxf

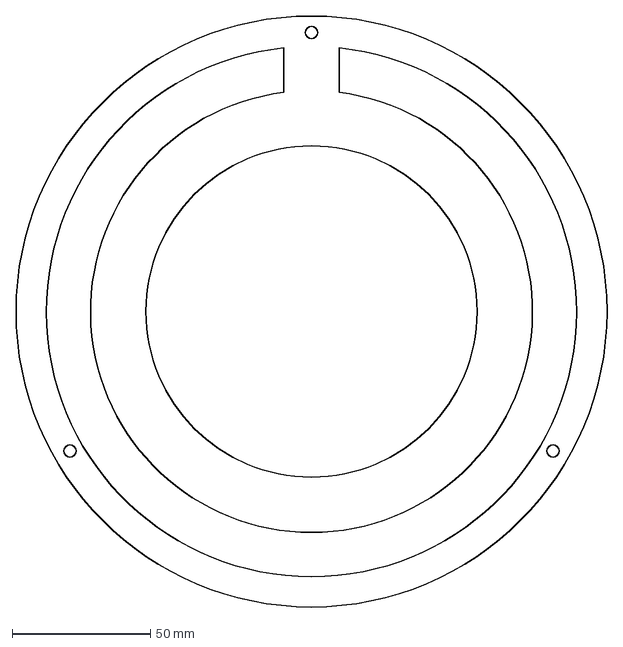
[picture p68: CAD file, 2026-11-05]
cad/v2/maple-5mm-led2.dxf
214.0 x 214.0 mm
