brennanMKE/TronCostume/cad/battery-holder-reference.stl

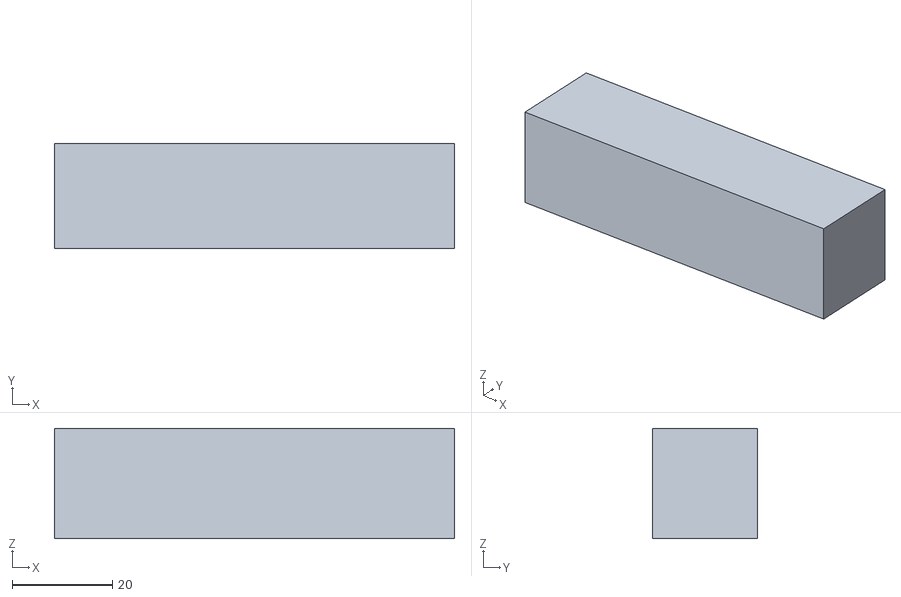
[picture p69: CAD file, 2026-11-05]
cad/battery-holder-reference.stl
80.0 x 21.0 x 22.0
