brennanMKE/TronCostume/cad/lid-inserts-reference.stl

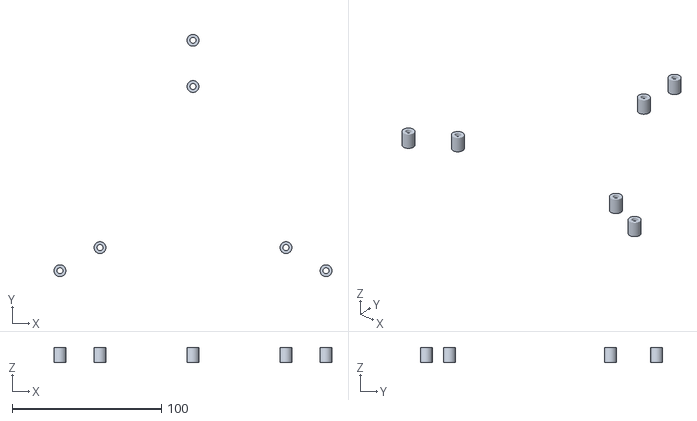
[picture p71: CAD file, 2026-11-05]
cad/lid-inserts-reference.stl
186.4 x 162.5 x 10.0
