brennanMKE/TronCostume/cad/v2/stl/box_hardware_ref.stl

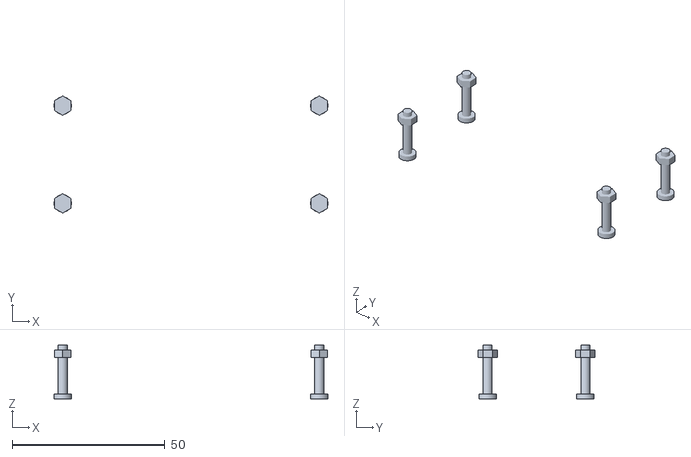
[picture p72: CAD file, 2026-11-05]
cad/v2/stl/box_hardware_ref.stl
89.7 x 38.4 x 17.6
