brennanMKE/TronCostume/cad/disc-base.step

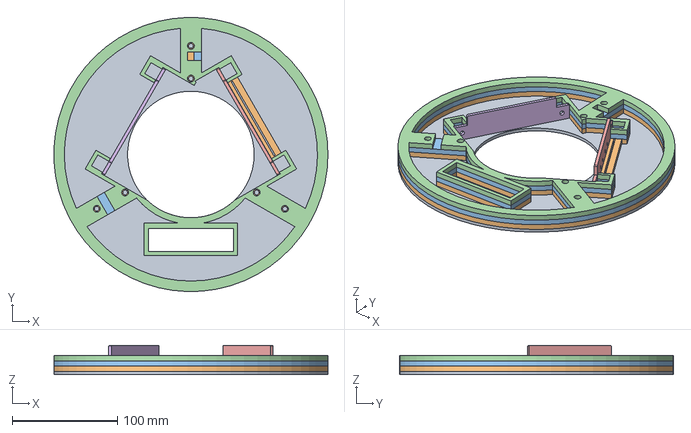
[picture p73: CAD file, 2026-11-05]
cad/disc-base.step
259.8 x 259.9 x 27.8 mm
