brennanMKE/TronCostume/cad/v2/stl/pod_trimpot.stl

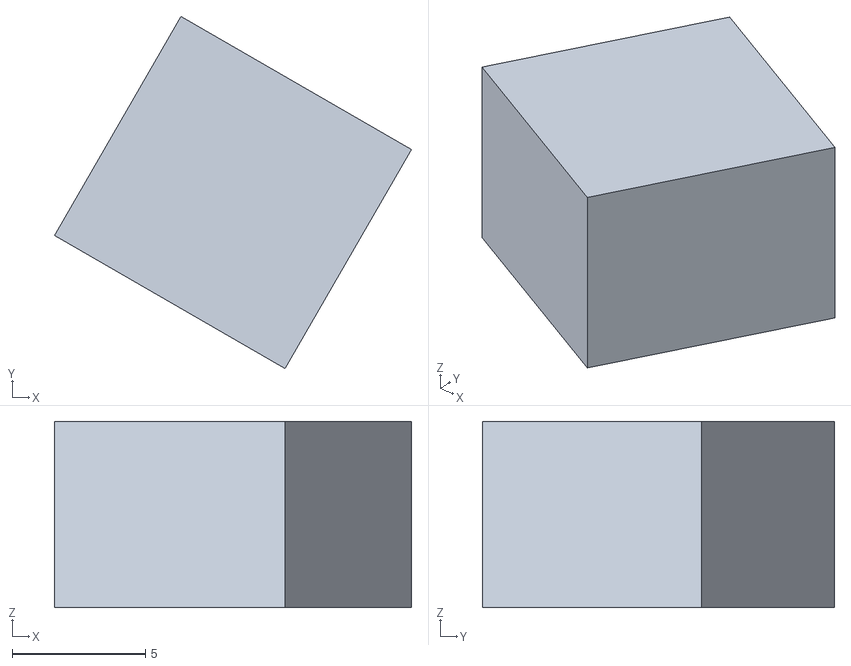
[picture p74: CAD file, 2026-11-05]
cad/v2/stl/pod_trimpot.stl
13.4 x 13.2 x 7.00
