brennanMKE/TronCostume/cad/acrylic-3mm-cover-buttons.step

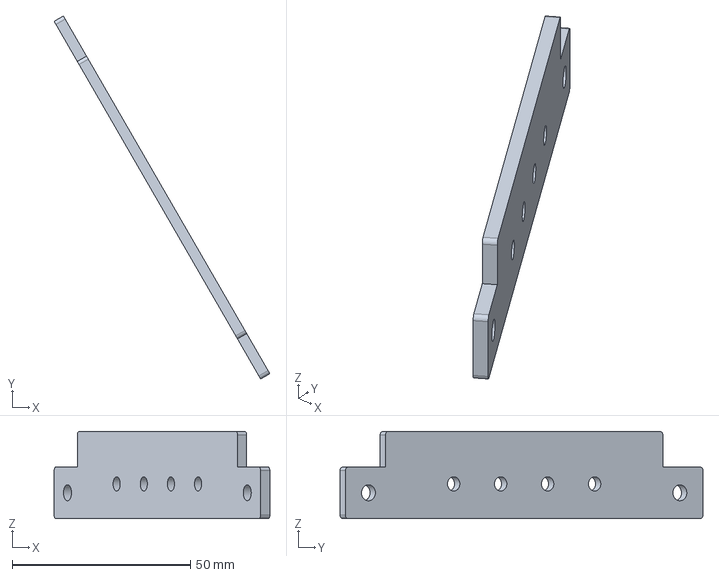
[picture p75: CAD file, 2026-11-05]
cad/acrylic-3mm-cover-buttons.step
60.6 x 102.0 x 24.5 mm
