brennanMKE/TronCostume/cad/v2/stl/pod_ics.stl

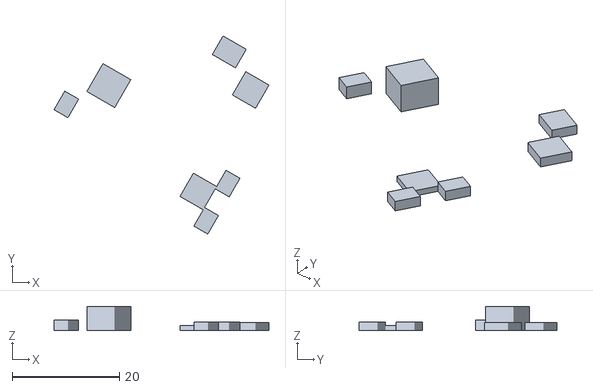
[picture p76: CAD file, 2026-11-05]
cad/v2/stl/pod_ics.stl
40.1 x 36.9 x 4.50
