brennanMKE/TronCostume/cad/protoboard-reference.stl

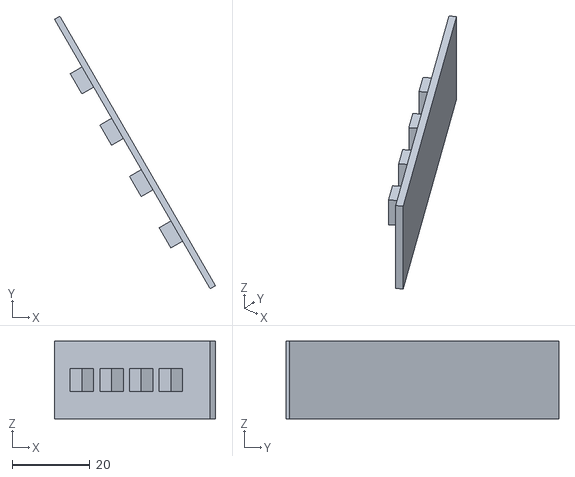
[picture p77: CAD file, 2026-11-05]
cad/protoboard-reference.stl
41.4 x 70.1 x 20.0
