brennanMKE/TronCostume/cad/maple-5mm-layer1.step

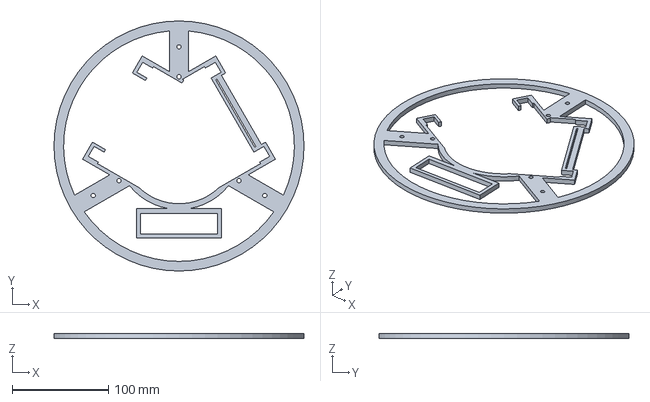
[picture p78: CAD file, 2026-11-05]
cad/maple-5mm-layer1.step
260.0 x 260.0 x 5.00 mm
