brennanMKE/TronCostume/cad/v2/stl/led2.stl

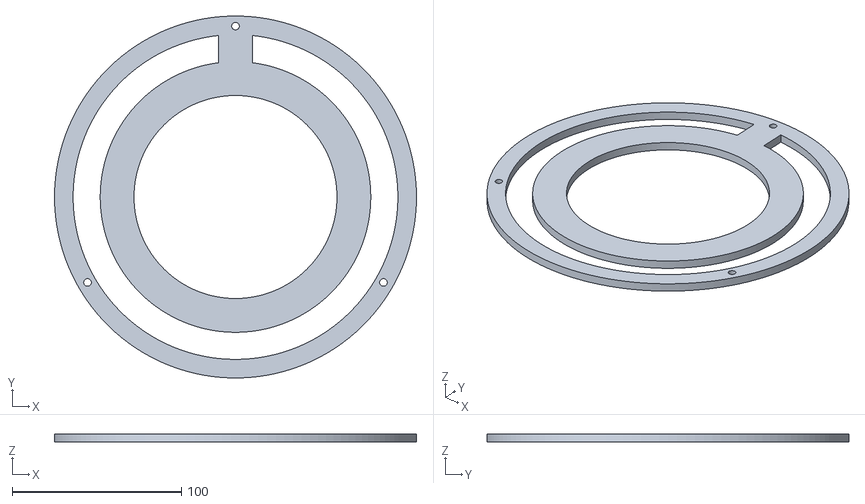
[picture p79: CAD file, 2026-11-05]
cad/v2/stl/led2.stl
214.0 x 213.9 x 5.00
