brennanMKE/TronCostume/cad/v2/stl/pod_pcb_blue.stl

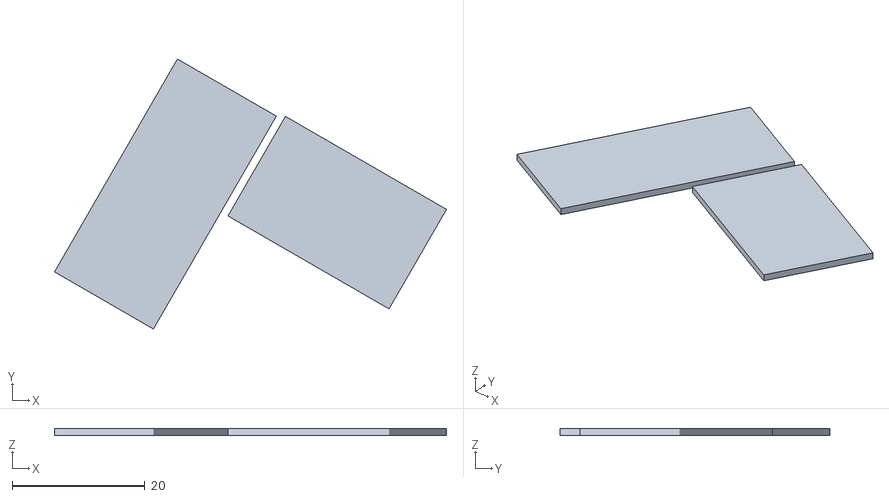
[picture p80: CAD file, 2026-11-05]
cad/v2/stl/pod_pcb_blue.stl
59.0 x 40.6 x 1.00
