brennanMKE/TronCostume/cad/v2/stl/pod_locator.stl

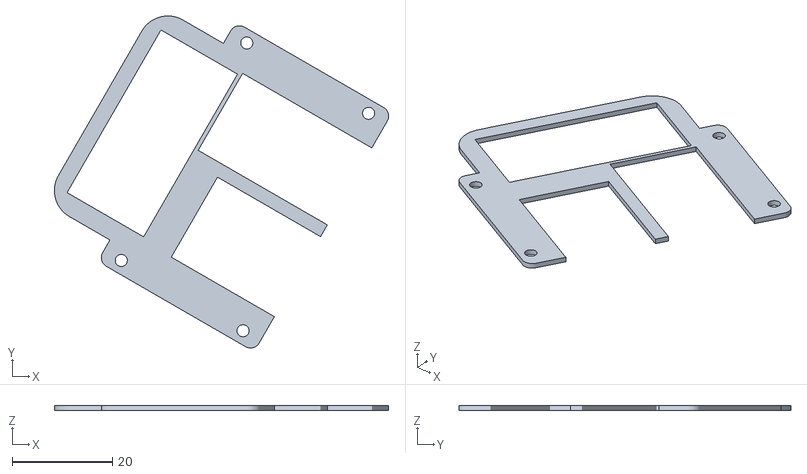
[picture p81: CAD file, 2026-11-05]
cad/v2/stl/pod_locator.stl
66.5 x 66.1 x 1.00
