brennanMKE/TronCostume/cad/v2/stl/buttons_ref.stl

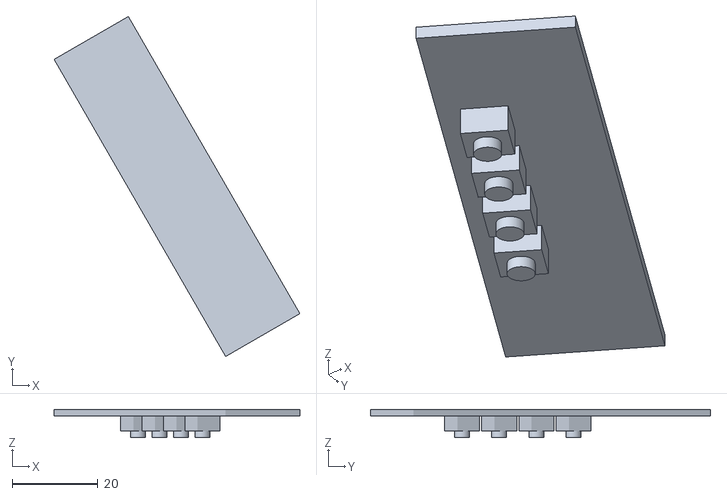
[picture p82: CAD file, 2026-11-05]
cad/v2/stl/buttons_ref.stl
57.3 x 79.3 x 6.60
