brennanMKE/TronCostume/cad/v2/stl/led_wire_strip.stl

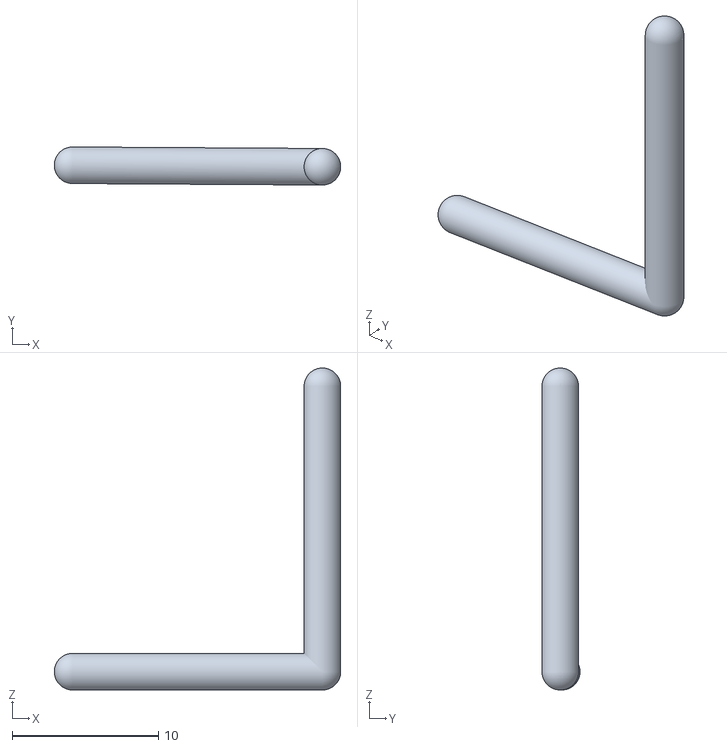
[picture p83: CAD file, 2026-11-05]
cad/v2/stl/led_wire_strip.stl
19.6 x 2.60 x 22.0
