brennanMKE/TronCostume/cad/v2/stl/pod_pcb_black.stl

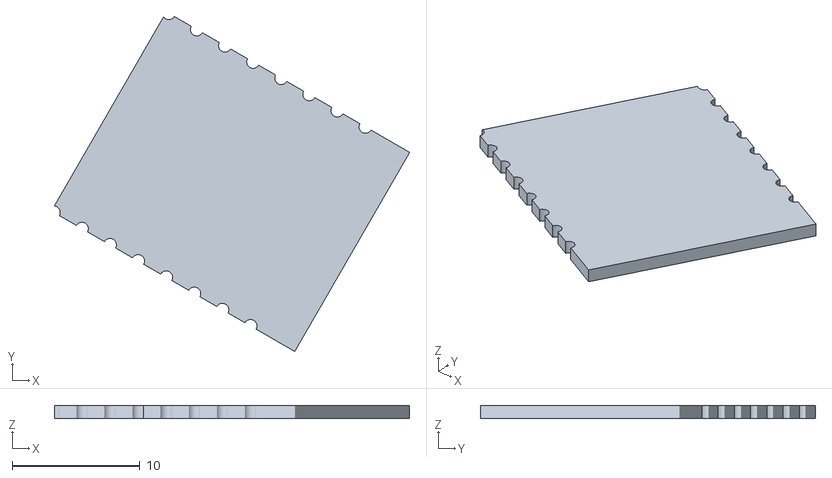
[picture p84: CAD file, 2026-11-05]
cad/v2/stl/pod_pcb_black.stl
27.8 x 26.2 x 1.00
