brennanMKE/TronCostume/cad/v2/stl/battery_box.stl

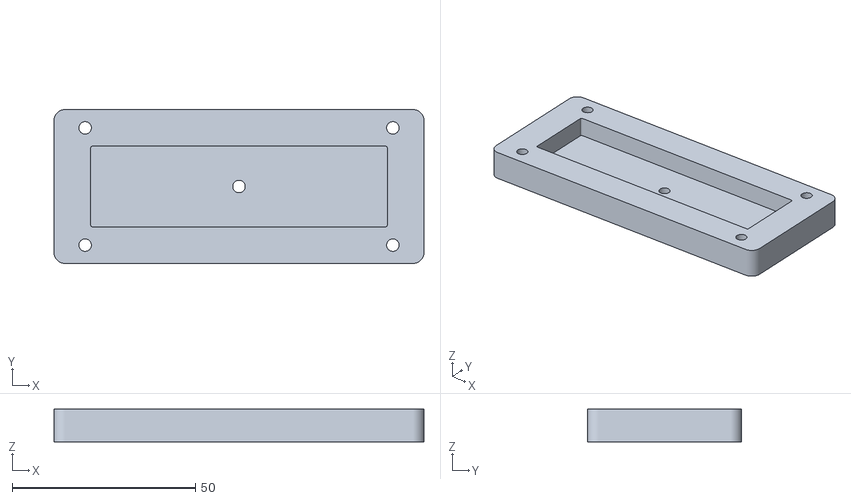
[picture p85: CAD file, 2026-11-05]
cad/v2/stl/battery_box.stl
101.0 x 42.0 x 9.00
