brennanMKE/TronCostume/(list of files, cad)

Other CAD files:
cad/v2/battery/stl/ring1.stl
cad/v2/stl/holder_ref.stl
cad/v2/stl/face.stl
cad/maple-5mm-layer2.step
cad/maple-5mm-layer4.step
cad/v2/stl/white_c.stl
cad/acrylic-3mm-back.step
cad/v2/stl/white_ring.stl
cad/v2/stl/frame3.stl
cad/v2/stl/cell_ref.stl
cad/v2/stl/frame1.stl
cad/acrylic-10mm-white-outer-ring.dxf
cad/acrylic-10mm-white-outer-ring.stl
cad/acrylic-3mm-back.dxf
cad/acrylic-3mm-back.stl
cad/acrylic-3mm-black-face.dxf
cad/acrylic-3mm-black-face.stl
cad/acrylic-3mm-cover-buttons.dxf
cad/acrylic-3mm-cover-buttons.stl
cad/acrylic-3mm-cover-usb.dxf
cad/acrylic-3mm-cover-usb.stl
cad/acrylic-3mm-white-c.dxf
cad/acrylic-3mm-white-c.stl
cad/lid-screws-reference.stl
cad/maple-5mm-layer1.dxf
cad/maple-5mm-layer1.stl
cad/maple-5mm-layer2.dxf
cad/maple-5mm-layer2.stl
cad/maple-5mm-layer3.dxf
cad/maple-5mm-layer3.stl
cad/maple-5mm-layer4.dxf
cad/maple-5mm-layer4.stl
cad/maple-5mm-layer5.dxf
cad/maple-5mm-layer5.stl
cad/v2/battery/stl/box_screws.stl
cad/v2/battery/stl/holder_screw.stl
cad/v2/stl/front_screws_ref.stl
cad/v2/stl/rear_screws_ref.stl
