brennanMKE/TronCostume/build-plans/render/disc-bays.png

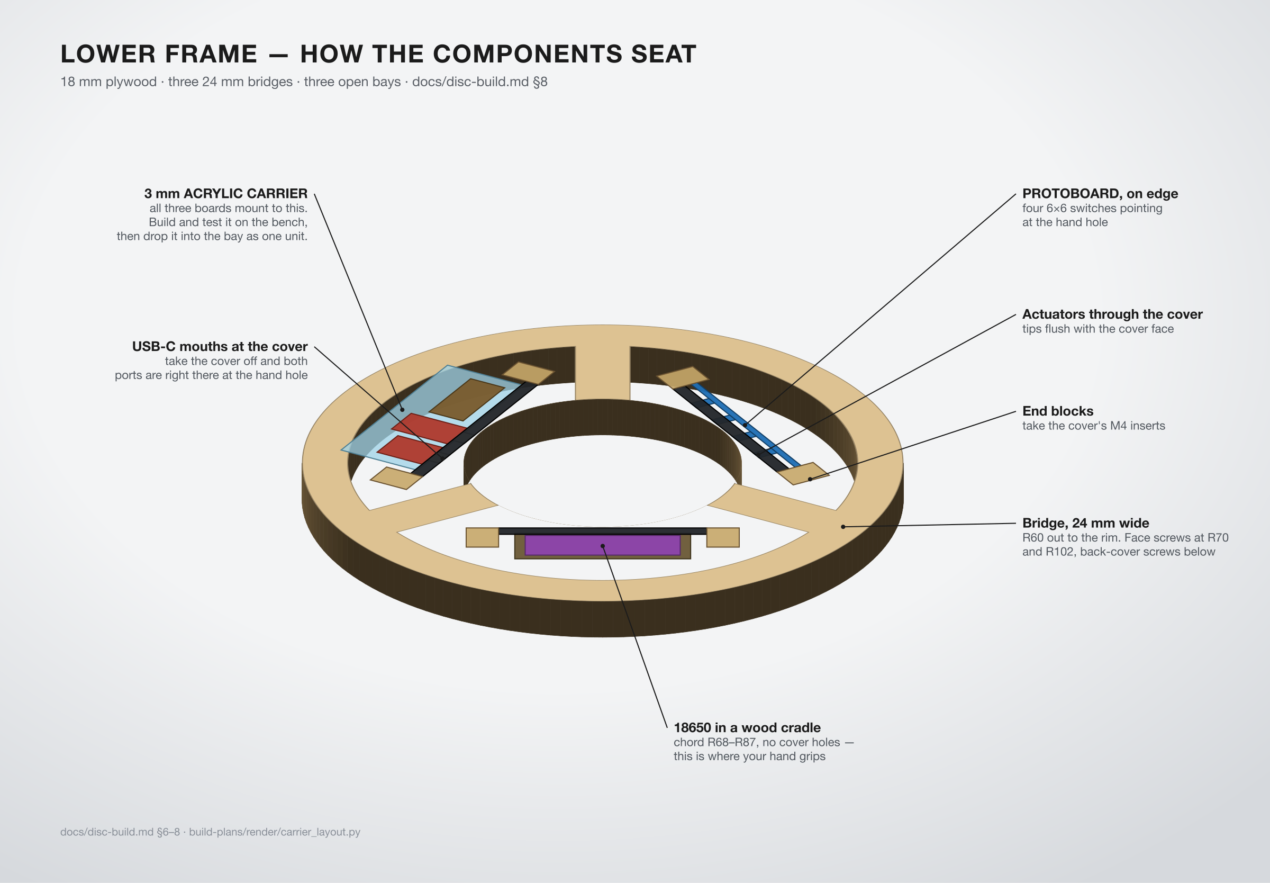
build-plans/render/disc-bays.png
