brennanMKE/TronCostume/build-plans/render/disc-exploded.png

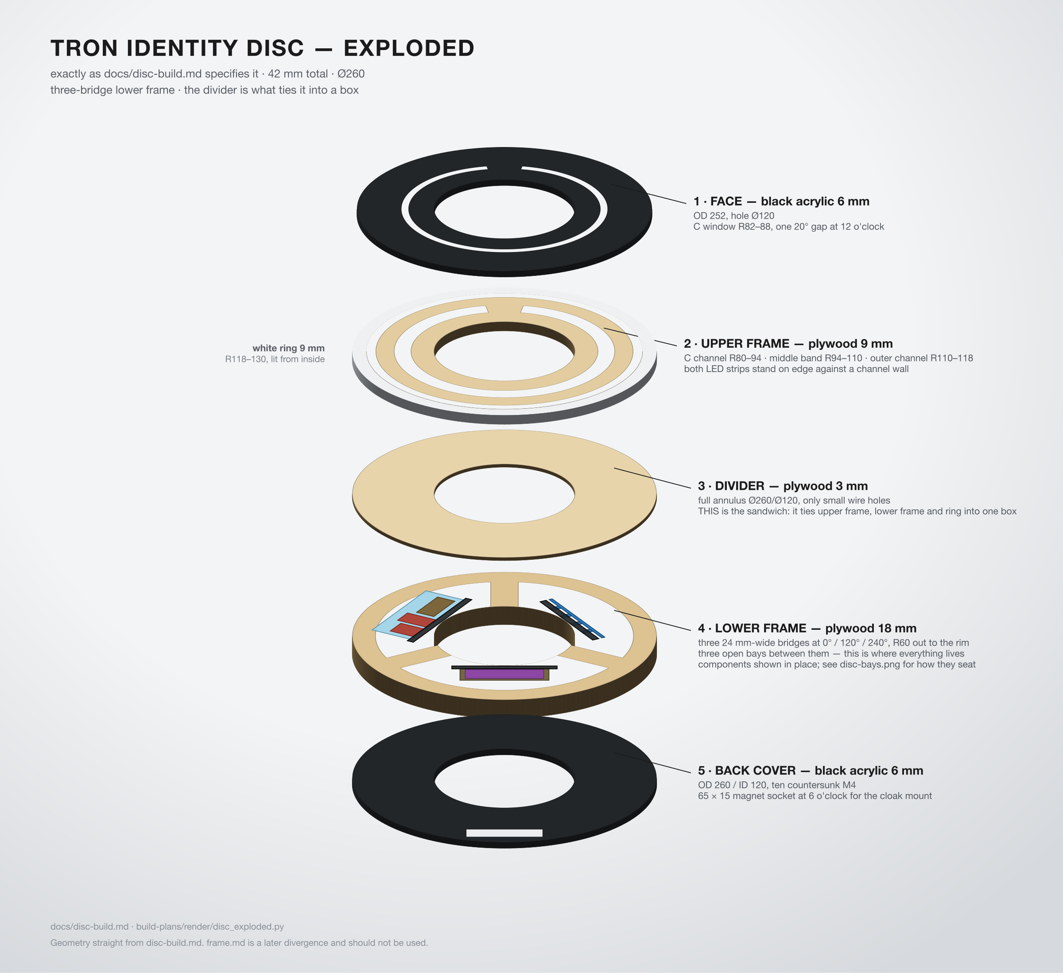
build-plans/render/disc-exploded.png
