brennanMKE/TronCostume/build-plans/render/frame-3d.png

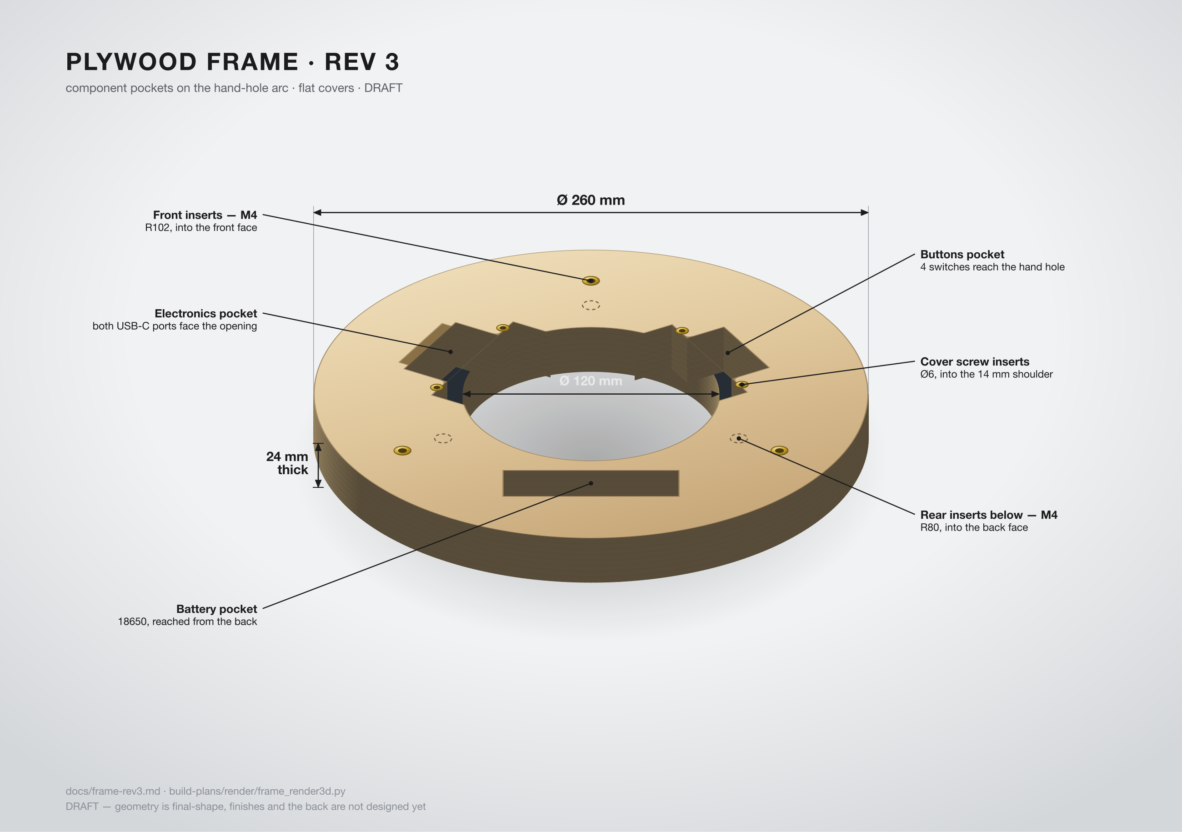
build-plans/render/frame-3d.png
