brennanMKE/TronCostume/build-plans/render/frame-plan-v2.png

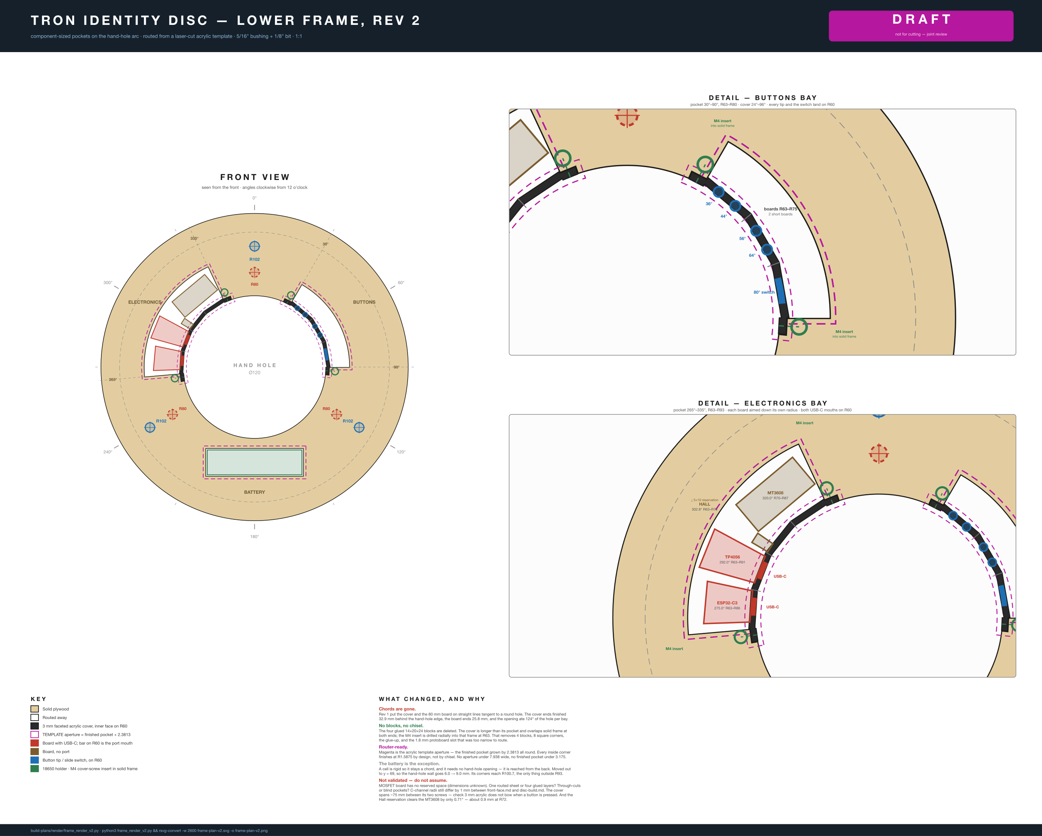
build-plans/render/frame-plan-v2.png
