brennanMKE/TronCostume/build-plans/render/frame-plan-v3-back.png

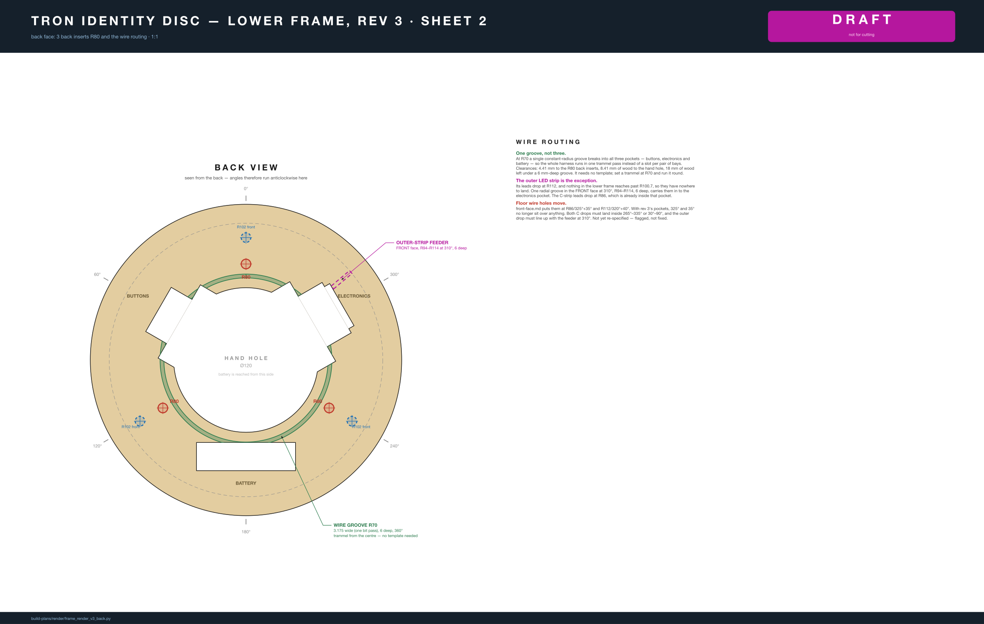
build-plans/render/frame-plan-v3-back.png
