brennanMKE/TronCostume/build-plans/render/frame-plan-v3.png

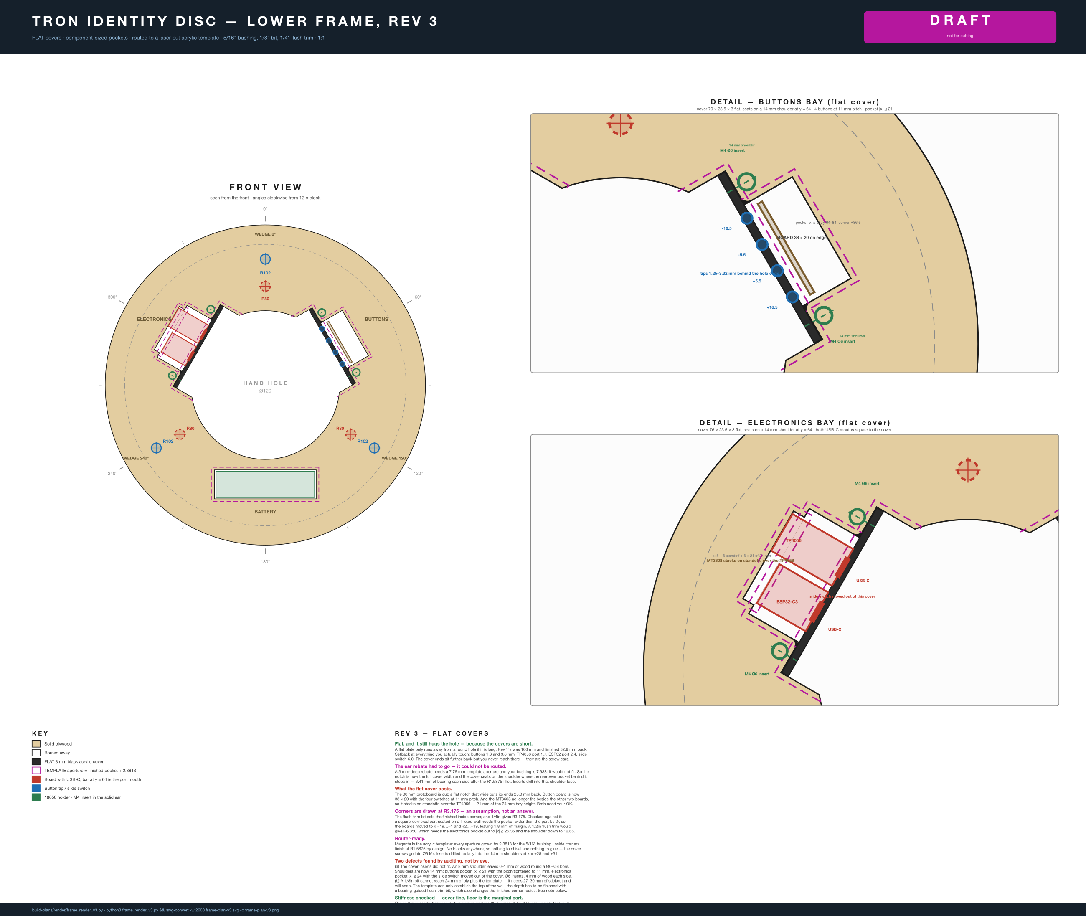
build-plans/render/frame-plan-v3.png
