brennanMKE/TronCostume/build-plans/render/frame-sections.png

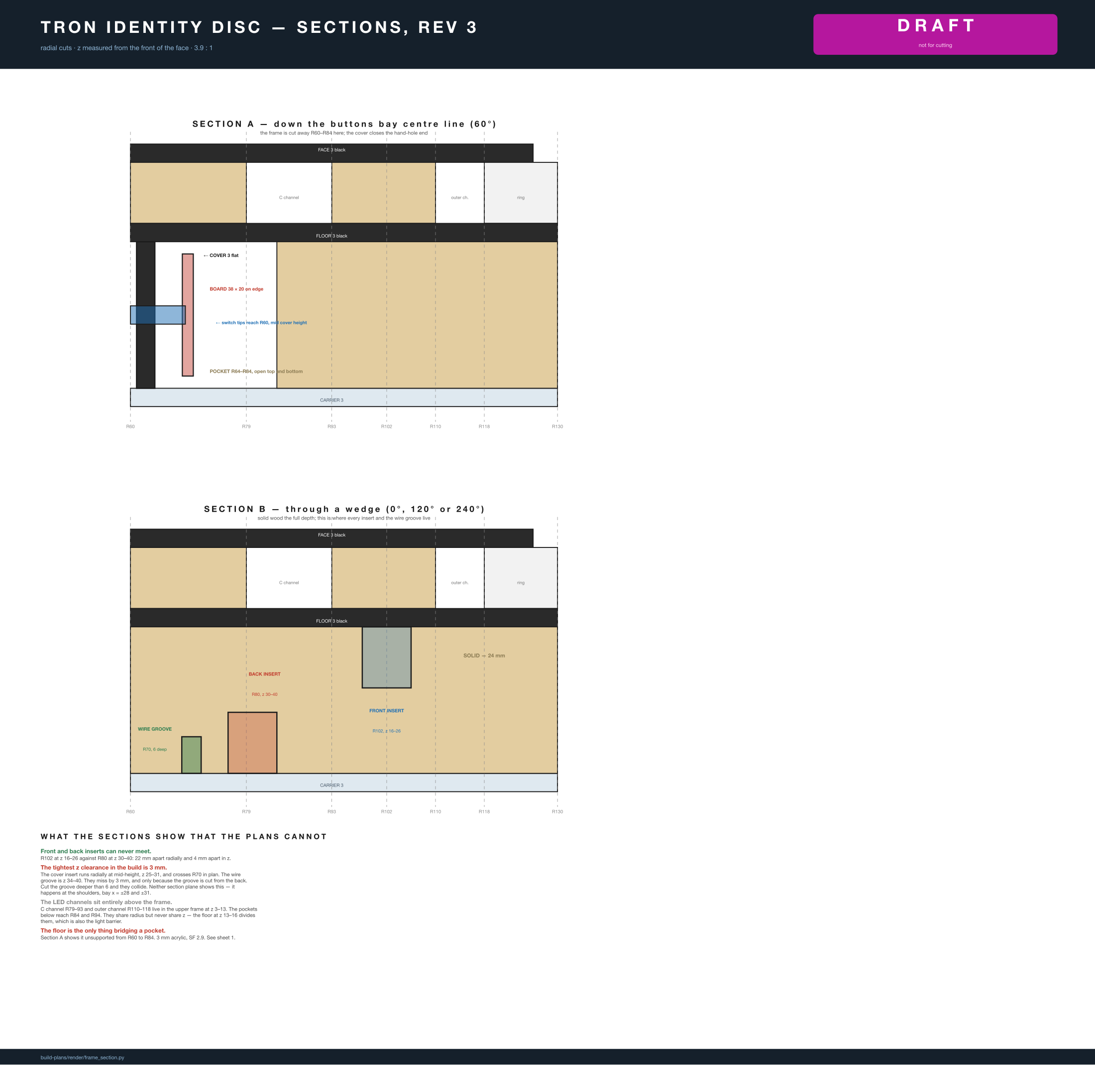
build-plans/render/frame-sections.png
