brennanMKE/TronCostume/build-plans/render/v4/CLOAK-WIRING.png

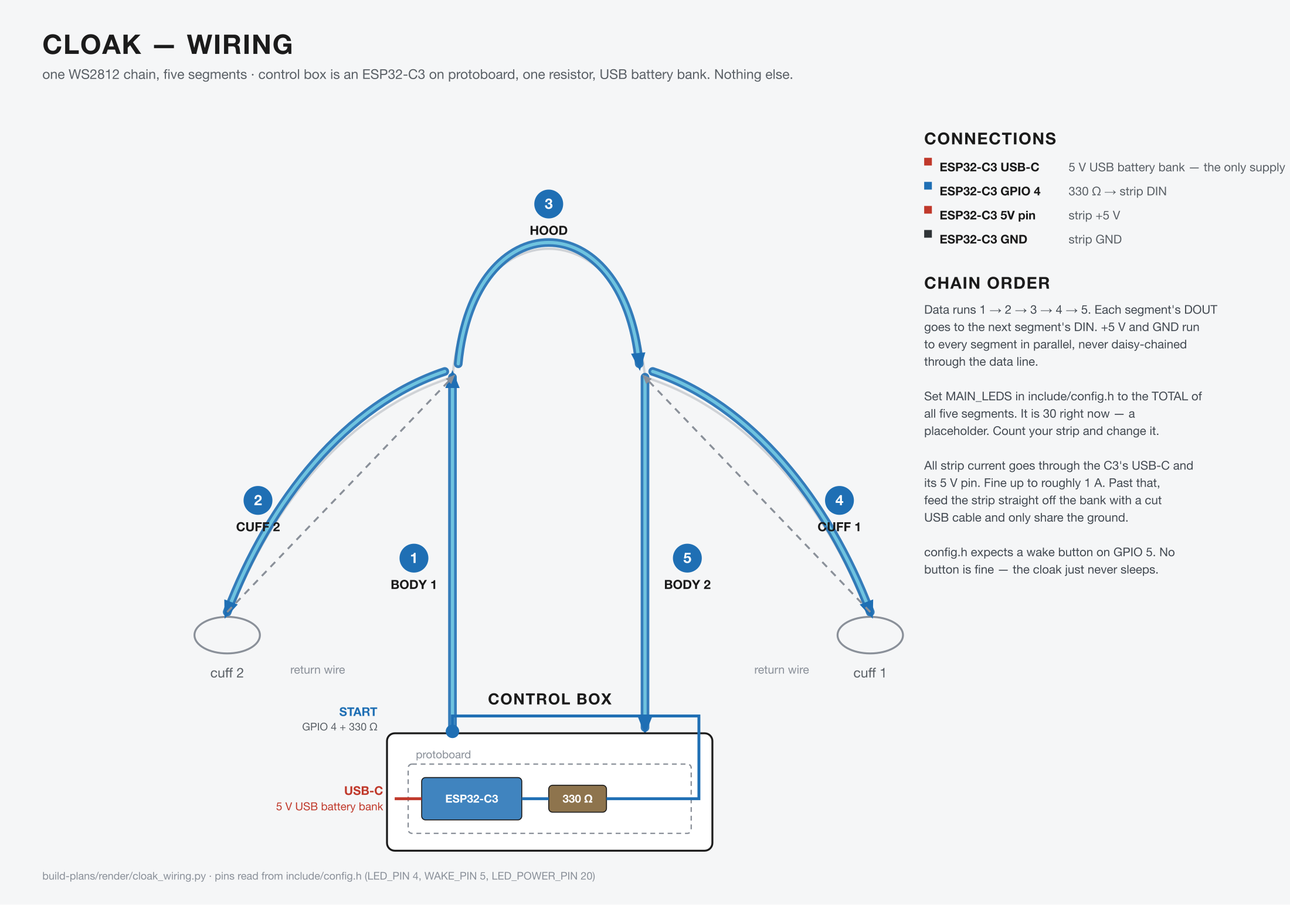
build-plans/render/v4/CLOAK-WIRING.png
