brennanMKE/TronCostume/build-plans/render/v4/PREVIEW-carrier-plate.png

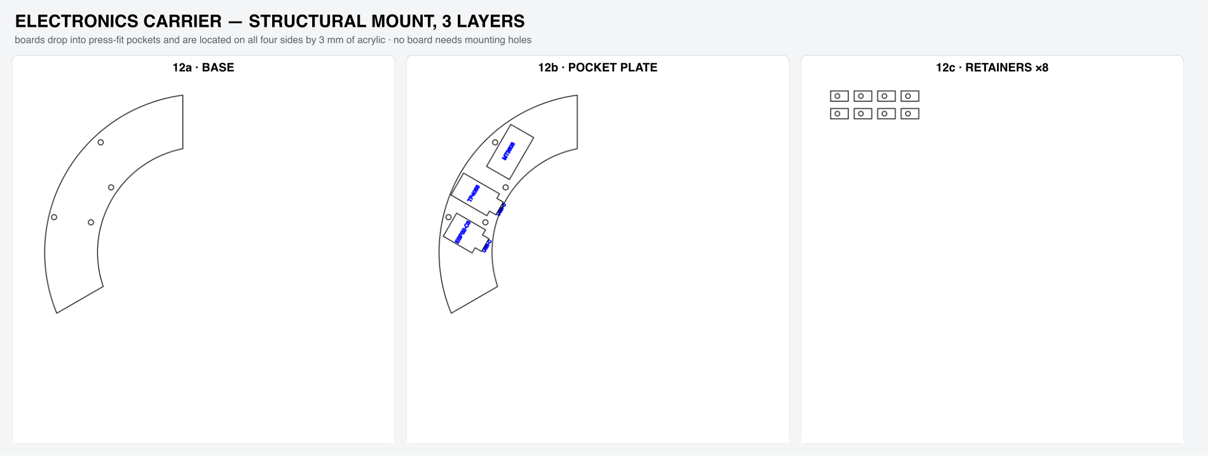
build-plans/render/v4/PREVIEW-carrier-plate.png
