brennanMKE/TronCostume/build-plans/render/v4/PREVIEW-lighting.png

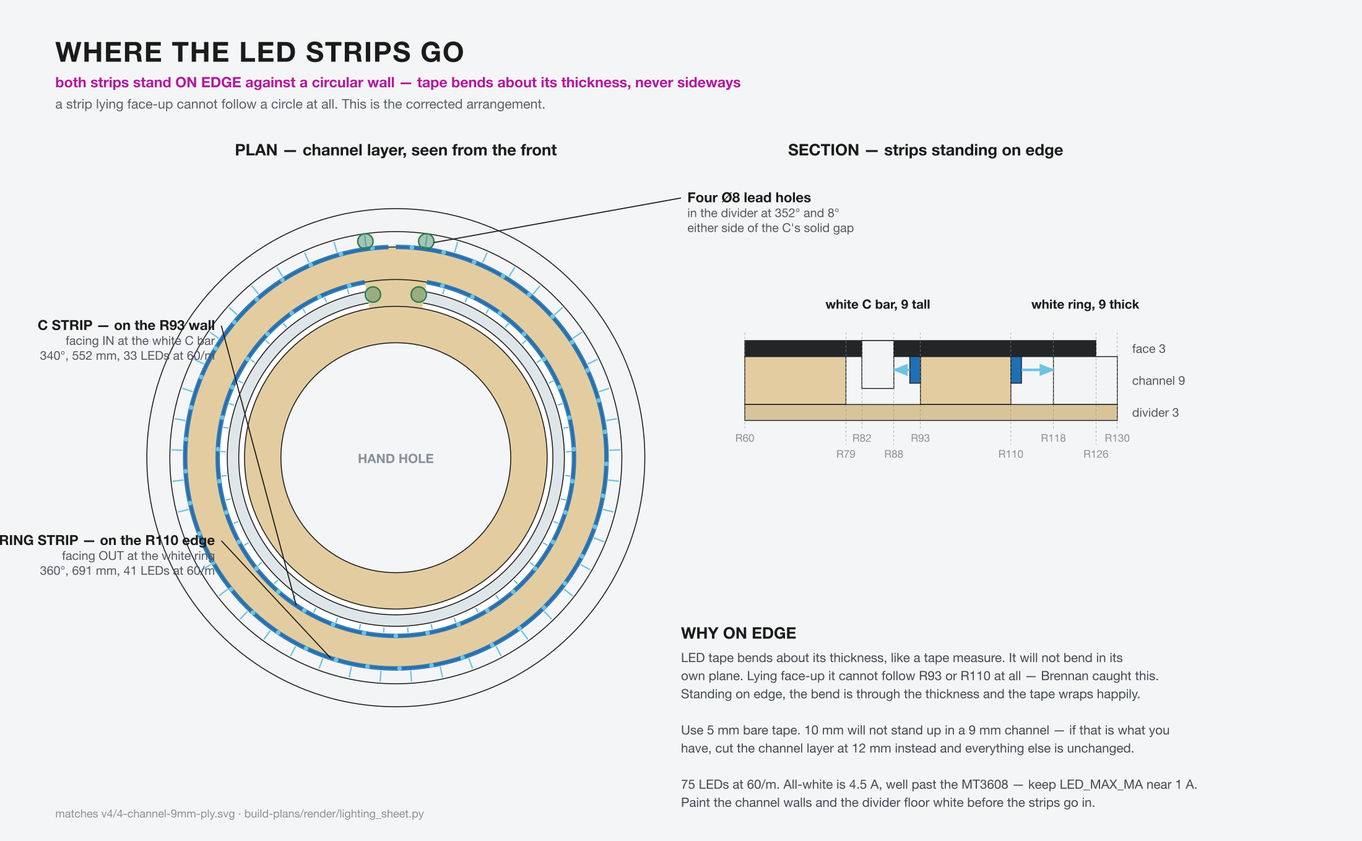
build-plans/render/v4/PREVIEW-lighting.png
