brennanMKE/TronCostume/build-plans/render/v4/PREVIEW-stack.png

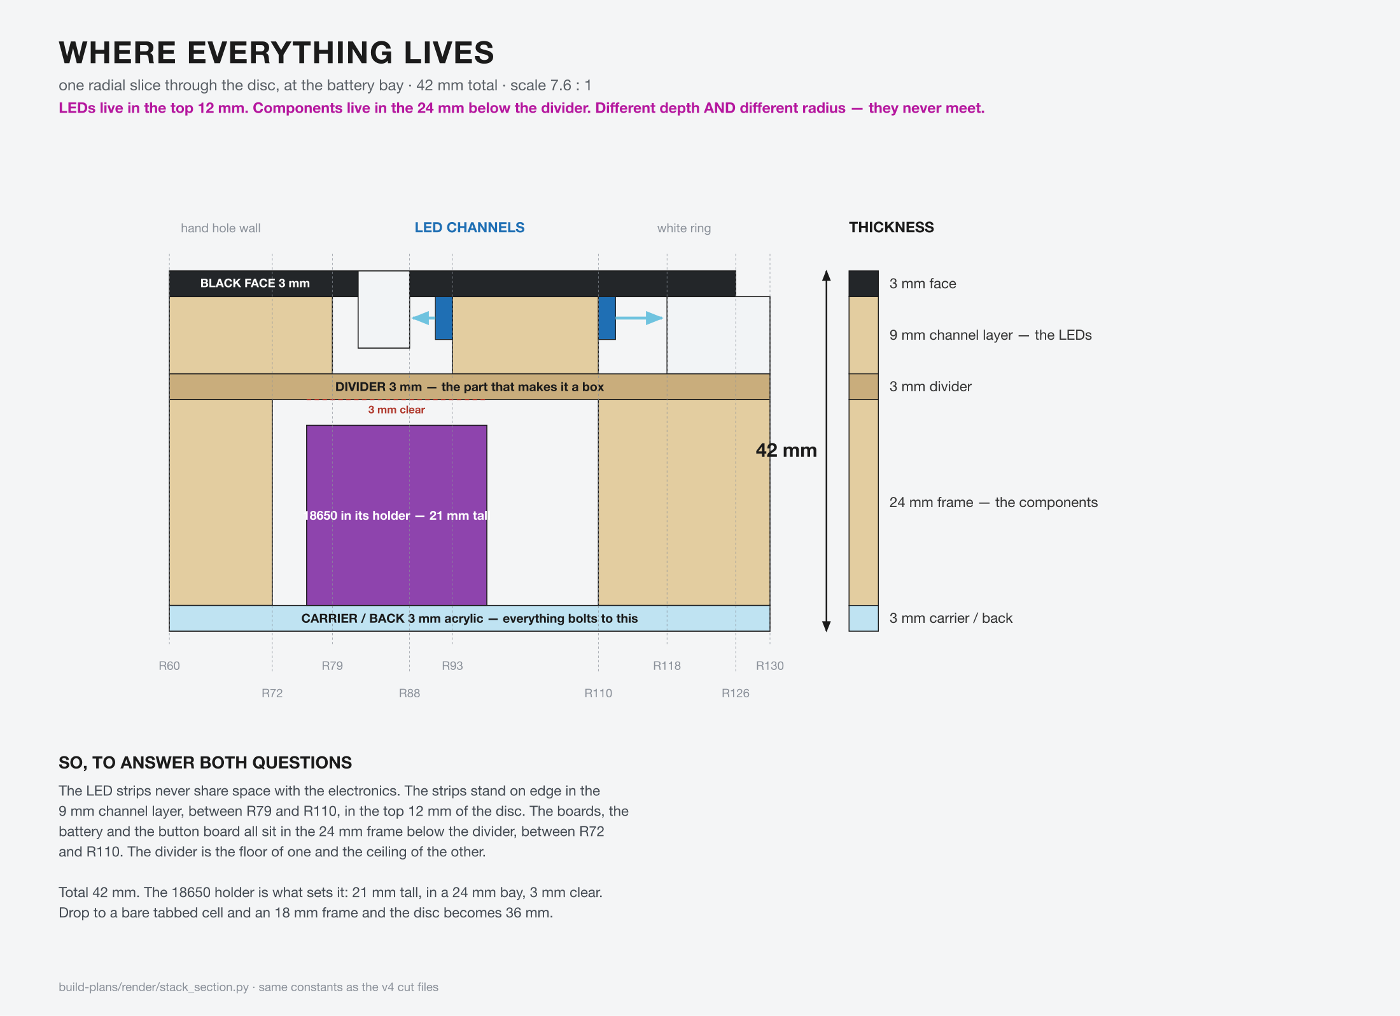
build-plans/render/v4/PREVIEW-stack.png
