brennanMKE/TronCostume/cad/out/frame.pdf

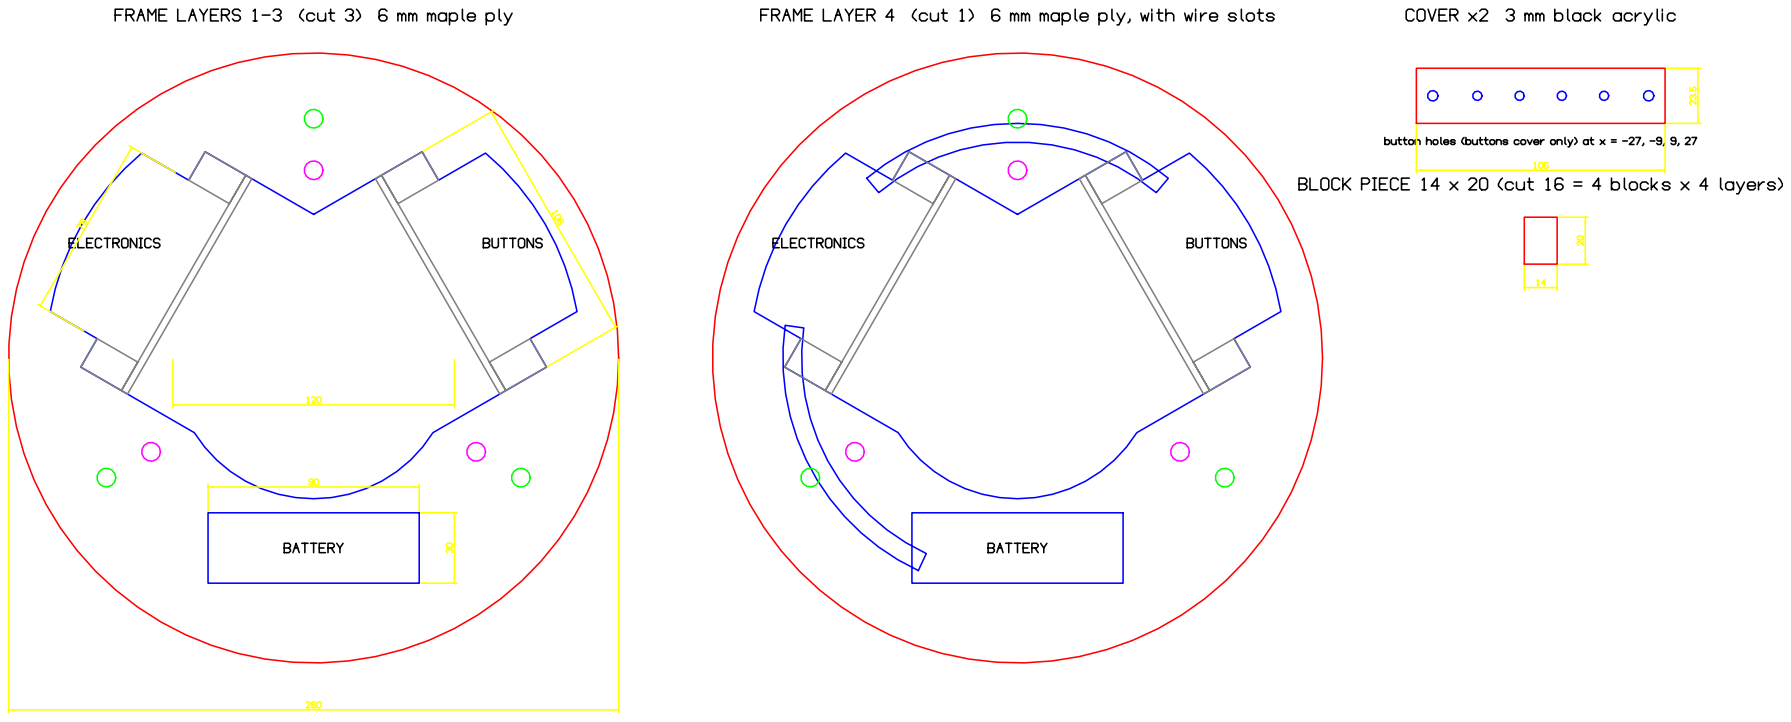
[picture p97: page 1]
