brennanMKE/TronCostume/(list of files, drawings)

Other design files:
cad/v2/pod/viewer/models/pcb_black.json
cad/v2/pod/viewer/models/pcb_blue.json
