brennanMKE/TronCostume/(commit log)

2026-10-29 Initial TronCostume firmware: disc and cloak linked over ESP-NOW
    One PlatformIO code base for two costumes, each an Identity Disc and a
    cloak on ESP32-C3 boards. Build envs disc-1/cloak-1/disc-2/cloak-2 set
    COSTUME_ID and DEVICE_ROLE; boards ignore packets from other costumes.
    - Disc has four color buttons (white/blue/red/green on GPIO 0/1/3/4);
    holding any for 3 s turns both boards' lights off.
    - Color changes are scheduled 50 ms ahead and the cloak lines up using
    PING/PONG round-trip latency, so both strips change together.
    - Heartbeat keeps the cloak in sync after lost packets or a reboot.
    - Hardware notes moved to docs/; README covers wiring, testing and
    open items.
    Co-Authored-B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
    [config.h, main.cpp]
2026-10-29 Add four-button controls, outer ring effects, saved color and disc build plan
    - Disc buttons: black (outer ring, off, wake), white, blue, green on
    GPIO 5/6/7/10. Tap for the primary color, double tap for its pair
    (yellow, red, orange); hold 1 s variants target both costumes (group
    message still to come). Black: tap ring on/off, double tap flicker,
    triple tap motion, hold 3 s off.
    - Six Tron colors; disc strip split into inner C (solid) and outer ring
    (on/off, ignition sweep, flicker, motion).
    - Disc saves its color to NVS and restores it at power-on; a button held
    at boot is ignored. Cloak starts dark until the disc sends a color.
    - Docs: controls, deep sleep and MOSFET plan, dis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
2026-10-29 Add frame and front face plans, Halloween cut files, new back mount
    - docs/frame.md: plywood frame with three bays, access covers on insert
    blocks, and front/back insert positions.
    - docs/front-face.md: 3 mm black face with inlaid white C, 10 mm white
    outer ring, light separation, face screws.
    - build-plans/halloween/: true-size SVG cut files for a simplified
    two-day build (face, C pieces, ring, channel layer, floor, back, jigs).
    - docs/disc-build.md: keyed bar-magnet back mount and revised render
    brief.
2026-10-30 Add parametric lower-frame drawing, mockup photos, and rework notes
    Generates a 1:1 scale drawing of the lower frame directly from the
    dimensions in docs/frame.md rather than prompting an image model, so the
    geometry can be scaled off and reused as the basis for a cut file.
    build-plans/halloween/ has cut files for the face, C, outer ring, channel
    layer, floor, back ply and jigs, but nothing for the 4-layer frame.
    build-plans/render/frame_render.py emits the sheet; frame-plan.svg/png are
    its output. Three views: front (3 M4 inserts at R102), back (3 M4 inserts
    at R80 plus the layer-4 wire slots), and a covered-bay detail.
    Geometry corrections found while drawing, audited independently by Co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
    [frame_render.py]
2026-10-30 Gamma-correct LED colors so the strip matches the screen hex values
    Low channel values (red's 0x2A of green and blue) showed near face value
    on WS2812s, turning red pink, orange yellow and yellow white. Tuned at
    gamma 2.6 on the ButtonsAndColors breadboard.
    [config.h, main.cpp]
2026-10-30 Add rev 3 frame plan with flat covers, plus routing template cut files
    Brennan rejected rev 2's faceted covers: "The cover over the battery charger
    and buttons will not be curved. Make it flat!"
    Flat works here because each cover is short and sized to its own features
    rather than spanning the bay. Setback behind the round hand-hole edge,
    measured at each feature: buttons 1.3 and 3.8 mm, TP4056 port 1.7, ESP32-C3
    port 2.4, slide switch 6.0. Rev 1's cover ends finished 32.9 mm back.
    The cover ear rebate is gone because it cannot be routed. A 3 mm-deep rebate
    needs a 7.76 mm template aperture and the guide bushing is 7.9375, so the
    bushing would not enter it. The notch is now the full cover w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
    [frame_render_v2.py, frame_render_v3.py, template_cut.py]
2026-10-30 Add rev 3 sheet 2: back face, inserts and wire routing
    One continuous groove at R70 in the back face replaces the per-pair arc slots
    of rev 1. R70 is the radius at which a single constant-radius pass breaks into
    all three pockets, so the whole harness is one trammel setup and needs no
    template. Clearances: 4.41 mm to the R80 back inserts, 8.41 mm of wood to the
    hand hole, 18 mm of wood left under a 6 mm-deep groove.
    The outer LED strip is the exception. Its leads drop at R112 and nothing in the
    lower frame reaches past R100.7, so a radial groove in the front face at 310 deg,
    R94-R114, carries them in to the electronics pocket. The C-strip leads drop at
    R86, already inside that pocket.
    Flag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
    [frame_render_v3.py, frame_render_v3_back.py]
2026-10-30 Add frame-rev3.md and mark frame.md superseded
    frame.md describes the rejected geometry: bays out to R114, 106-long chord
    covers whose ends finish 32.9 mm behind the hand hole, and four glued blocks.
    Anything reading it as the spec gets misled, so it now carries a pointer at the
    top and the live numbers live in frame-rev3.md.
    frame-rev3.md matches the rev 3 drawings exactly and is generated from the same
    constants: flat covers seating on a routed shoulder, component-sized pockets,
    no blocks, the R70 wire groove, and the router/template figures. It also carries
    the four open questions and the two doc conflicts inline rather than burying
    them, so they cannot be missed before cutting.
    Marked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
2026-10-30 Widen the cover shoulders to 14 mm; flag that a 1/8in bit cannot reach
    Two defects found by auditing the geometry against the tooling rather than by
    looking at the drawing.
    1. The cover inserts did not fit. The shoulder the cover seats on was 8 mm
    wide, which leaves 0 mm of wood around a Ø8 insert bore and 1 mm around a
    Ø6. Shoulders are now 14 mm, giving 4 mm each side of a Ø6 bore. Paying for
    that width needed the pockets narrowed: the buttons pitch drops to 11 mm so
    the board is 38 x 20 and the pocket is |x| <= 21, and the slide switch comes
    out of the electronics cover so that pocket is |x| <= 24. The slide switch
    has no new home yet.
    2. A 1/8in bit cannot cut the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
    [frame_render_v3.py]
2026-10-30 Draw real corner fillets and make the radius a single parameter
    The corner radius is set by the flush-trim bit, which Brennan has not named
    yet, so RCORNER is now one constant at the top of the generator and the
    drawings show actual fillets instead of sharp corners plus a note. Changing
    the answer is a one-line edit and a re-run.
    Default is 3.175 (1/4in flush trim), with the reasoning recorded: a
    square-cornered part seated against a filleted wall needs the pocket wider
    than the part by 2r at that wall, so
    1/4in R3.175 usable span in the electronics pocket 41.65 vs 38 needed ok
    1/2in R6.350 usable span 35.30 vs 38 needed short by 2.70
    A 1/2in flush trim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
    [frame_render_v3.py]
2026-10-30 Check cover and floor stiffness; retract the cover-bow concern
    Earlier sheets carried "check 3 mm acrylic does not bow when a button is
    pressed" as an open worry. Run the numbers under a 20 N press and it is not a
    concern: the cover deflects 0.46-0.63 mm between its two screws at a safety
    factor of about 8. That flag is withdrawn.
    The floor is the part that deserved the worry. Where it bridges the electronics
    pocket it is unsupported over 27 mm radially, giving 1.30 mm of deflection and
    SF 2.9 on a cantilever model. Still adequate, and conservative because the real
    plate is supported on three sides, but it is the thinnest margin in the
    assembly and acrylic is brittle.
    Two ways to buy margi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
    [frame_render_v3.py]
2026-10-30 Add sheet 3: radial sections through the z stack
    The plan views place everything in radius and angle but nothing in z, which is
    where the remaining conflicts live. Two cuts: one down a covered bay's centre
    line showing the cover, the board on edge and the switch tips reaching R60,
    and one through a wedge showing both inserts and the wire groove in the solid
    wood that carries them.
    What the sections make visible:
    - Front insert z 16-26 against back insert z 30-40: 22 mm apart radially and
    4 mm apart in z, so they can never meet.
    - The tightest z clearance in the build is 3 mm, between the cover insert at
    z 25-31 and the wire groove at z 34-40. They share radius at R70 and miss
    only be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
    [frame_section.py]
2026-10-30 Add a review index that matches the current state
    The copy of this on the MacBook had gone stale the moment the shoulders were
    widened: it still quoted a 46 x 20 button board, 12 mm switch pitch and inserts
    at x = +/-29 and +/-34. That is the same failure as docs/frame.md describing
    rejected geometry, so it is now regenerated alongside the sheets and kept in
    the repo as well.
2026-10-30 Deep sleep on black hold 3 s; wake disc and cloak together
    - Black hold 3 s saves the color, turns both off, then the disc deep
    sleeps once every button is released. Black (GPIO 5) wakes it.
    - On wake the disc schedules its saved color so the cloak lights at the
    same moment.
    - Black tap returns flicker/motion to steady; otherwise toggles the ring.
    - Button pins follow the protoboard order: black 5, white 6, green 7, blue 10.
    - disc-1-bench env: 11-LED test strip used entirely as the outer ring.
2026-10-30 Add CADCraft notes and frame drawing
    [frame.dxf]
2026-10-30 Render the frame as a 3D view, not a plan sheet
    Brennan asked for image renderings in the first message and said "start
    simple". I delivered flat CAD plan sheets and then kept adding analysis to
    them. concepts/Three-bridge plywood annular frame.png is what a rendering
    means in this project: a tilted 3D view of the actual wooden part, laminated
    edges and brass inserts visible, a handful of clean callouts. None of my
    sheets let you look at them and see the object, which is why none of it was
    usable to him.
    The geometry is unchanged and imported directly from frame_render_v3, so this
    is the same rev 3 part, not a redraw. A tilted disc projects affinely, so the
    plan geometry is reused as-is: po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
2026-10-30 Render disc-build.md's actual design: exploded view and bay layout
    The design Brennan has been asking for is already written down, in
    docs/disc-build.md. Its cross-section specifies a five-layer laminated box —
    face 6, upper frame 9, divider 3, lower frame 18, back cover 6, 42 total —
    with a three-bridge lower frame, three open bays, and a 3 mm acrylic carrier
    for the electronics. That is the concept image he kept pointing at.
    docs/frame.md is a later divergence that threw it away: it replaced the box
    with a single routed core and the open bays with component-shaped pockets.
    disc-build.md line 409 records that exact comparison and rejects the routed
    core. I worked from frame.md because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
    [carrier_layout.py, disc_exploded.py]
2026-10-30 Add v4: complete cut-file set and build plan for the three-bridge disc
    Brennan needs a viable build by morning and asked for decisions to be made
    rather than options listed. This is the whole set, generated from one block of
    constants in build_v4.py so nothing can disagree with anything else.
    Stack, 42 mm: top plate 3 acrylic / channel layer 9 ply / divider 3 ply /
    frame 24 ply / carrier 3 acrylic. The divider is a full unbroken annulus glued
    between the channel layer and the frame, which is what makes the disc a closed
    box rather than a stack of rings.
    Nine files plus BUILD-PLAN.md. The two he needs first are the router template
    and the carrier.
    Decisions taken, with reasons recorded in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
2026-10-30 Reconcile v4 with Codex's rear carrier: adopt the documented 10 fasteners
    Codex and I had produced two sets that did not bolt together. Three
    disagreements, resolved:
    1. Back fasteners. Mine were three at R80, which I invented rather than read.
    disc-build.md specifies ten: R70 and R102 on each bridge plus R122 at
    60/155/205/300, and the four rim screws are what hold the outer rim down.
    His pattern wins and is now in the frame, the carrier and the template's
    engrave layer. All thirteen fasteners verified to land in solid wood, and
    the front set at R96 sits in the channel layer's solid R91-117 band so it
    cannot break into a light channel.
    2. Wire path. His note said the har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
    [build_v4.py]
2026-10-30 Add PNG previews for v4 — a contact sheet and the bay layout
    Shipped nine SVG cut files with no way to look at them, which was not much
    use to someone who needs to see the design. Two PNGs now sit alongside them:
    - PREVIEW-all-parts.png: every cut file on one sheet, labelled, with the two
    to cut first marked.
    - PREVIEW-bays.png: the frame in 3D with the components seated, regenerated
    from the v4 constants so it matches the template exactly rather than the
    earlier disc-build.md geometry.
2026-10-30 Add the lighting sheet: where both LED strips sit
    The bay preview showed the frame but nothing about the light, which was the
    next thing Brennan asked. PREVIEW-lighting.png gives the plan and a radial
    section of the top three layers.
    Both strips lie flat on the divider with the LEDs facing up at the white
    acrylic 7 mm above: the C strip on R85 over 340 deg, 504 mm, 30 LEDs at 60/m,
    and the ring strip on R122 full circle, 767 mm, 46 LEDs. Leads drop through
    the four 8 mm divider holes at R85 and R122, at 352 and 8 deg, either side of
    the C's solid bridge at 12 o'clock.
    Also recorded the current budget, which matters: 76 LEDs all-white at full
    brightness is 4.6 A and the MT3608 will not deli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
2026-10-30 Fix the lighting: strips stand on edge, not flat. Brennan caught this
    LED tape bends about its thickness, like a tape measure, and will not bend in
    its own plane. A strip lying face-up therefore cannot follow a circle at all,
    so the flat-on-the-divider arrangement I specified was unbuildable. Brennan
    caught it before anything was cut.
    This is the same error as choosing frame.md over disc-build.md: I overrode the
    document without understanding the constraint behind it. disc-build.md says
    both strips stand on edge against a channel wall, and that is the only
    arrangement that works.
    Corrected:
    - C strip stands on the R93 wall facing inward, 340 deg, 552 mm, 33 LEDs at
    60/m. Ring strip stan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
    [build_v4.py, lighting_sheet.py]
2026-10-30 Add the whole-stack section — the picture that should have existed first
    Brennan asked where the components go once the LEDs are in, and how thick the
    build is. Fair questions: I had an exploded view, a bay view and a lighting
    view, but nothing showing the LEDs and the electronics in the same picture,
    which is exactly why it read as confusing.
    One radial slice through the battery bay, the tightest one. The LEDs stand on
    edge in the 9 mm channel layer between R79 and R110, in the top 12 mm. The
    boards, battery and button board sit in the 24 mm frame below the divider,
    between R72 and R110. Different depth and different radius, so they never
    compete for space; the divider is the floor of on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
    [stack_section.py]
2026-10-30 Add laser-cut frame layers and the buildability audit
    I did not work overnight — the session ended at 01:16 and the buildability
    pass I promised did not happen. Doing it now surfaced a better route and two
    real fixes.
    The frame is a constant cross-section: every feature in it is a through-cut.
    So the laser can cut it as N identical layers and the entire router workflow
    becomes optional. Files 10 and 11 are that layer, one plain and one carrying
    an 8 mm notch across each bridge; put the notched layer anywhere in the middle
    of the stack and the notches become the wire tunnels. 24 mm is 8x3, 6x4, 4x6
    or 2x12. This removes the template, the OD guide disc, the two-stage depth,
    the flush-trim b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
    [build_v4.py]
2026-10-30 Add the electronics carrier plate, from Brennan's measured MT3608
    Both photos he dropped are the MT3608 boost, 1.29 x 0.70 in = 32.8 x 17.8,
    and the important detail is that it has no mounting holes - the four large
    pads are wire pads. The ESP32-C3 Super Mini and most TP4056 boards are the
    same, and I cannot check his, so nothing on this plate relies on a board
    having holes. Each board is held by a cable tie through a pair of 1.8 x 14
    slots either side of it, plus foam tape.
    The plate is a sector of the 300 deg bay, R72-R108, inset 2 mm off each
    bridge, so it drops in and cannot be fitted the wrong way round. Both USB-C
    mouths sit on the inner arc facing the hand hole, which is what he aske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
    [carrier_plate.py]
2026-10-30 Replace the carrier's cable ties with a real structural mount
    Brennan: 'Did you consider any structural way to mount the components?' No, I
    had not. Cable ties and foam tape located nothing and I reached for them
    because I could not verify whether his boards have mounting holes. That was
    avoiding the design problem rather than solving it.
    The mount is now two cemented layers. 12a is a plain sector; 12b is the same
    sector with a pocket cut for each board. Cemented together they give a 3 mm
    deep pocket shaped to each board, so it is located on all four sides by solid
    acrylic and still needs no mounting holes of its own. Pockets are board size
    +0.2 and the kerf makes that a push fit. A notch a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
    [carrier_plate.py]
2026-10-30 Add the cloak wiring diagram from Brennan's sketch
    His sketch is the cloak, not the disc: hood, two body panels, two cuffs and
    a control box. Drawn as one WS2812 chain in five segments with the direction
    of travel marked and a START at the control box, so it can be followed
    without interpreting arrows.
    Pins are read from include/config.h rather than invented: LED_PIN 4 through
    330 ohm to the first DIN, WAKE_PIN 5 for the single button to ground,
    LED_POWER_PIN 20 reserved for the strip MOSFET that is not fitted. Power
    chain is 18650 - TP4056 - MT3608 - strip and board, same as the disc.
    Two things flagged on the sheet. MAIN_LEDS is 30 for the cloak, which is a
    placeholder and must be set to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
    [cloak_wiring.py]
2026-10-30 Strip the cloak diagram to what is actually in the control box
    I put the disc's power chain on the cloak. It is not there. The cloak control
    box is an ESP32-C3 on protoboard, one 330 ohm resistor, and a 5 V USB battery
    bank into the board's USB-C. Removed the 18650, TP4056, MT3608 and the button,
    and cut the connections table to the four lines that exist.
    Added the one thing that follows from USB-bank power: all strip current now
    goes through the C3's USB-C and its 5 V pin, which is fine to roughly 1 A. Past
    that the strip wants feeding straight off the bank with a cut USB cable,
    sharing only the ground.
2026-10-31 Rebuild disc CAD as a parametric layer stack with cut files and 3D board
    cad/disc.py builds the full stack (back, five maple layers, white ring,
    face and C, bay covers, battery holder) in build123d. Cut files, STEP/STL
    and the 3D viewer source live in cad/. docs/cad-status.md records the
    current state and open questions.
    [acrylic-10mm-white-outer-ring.dxf, acrylic-10mm-white-outer-ring.step, acrylic-10mm-white-outer-ring.stl, acrylic-3mm-back.dxf, acrylic-3mm-back.step, acrylic-3mm-back.stl, acrylic-3mm-black-face.dxf, acrylic-3mm-black-face.step]
2026-10-31 Note checked screw and insert positions for the lid/base split
2026-10-31 Split the disc into a screwed-on lid and base for service
    Six M4 x 25 button heads at R72/R103 on the ribs hold the lid (face, C,
    white ring, maple 4-5) to the base (back, maple 1-3). Clearance holes in
    the lid, laser-cut insert pilots in layers 2-3, a screw-tip relief in
    layer 1, a looser layer 4 board slot, and a reference LED connector.
    Re-exported the changed cut files and added lift-lid views to the board.
    [acrylic-3mm-black-face.dxf, acrylic-3mm-black-face.step, acrylic-3mm-black-face.stl, disc-assembly.step, disc-base.step, disc-lid.step, led-connector-reference.stl, lid-inserts-reference.stl]
2026-10-31 Add disc v2: three-bridge frame with a removable back
    disc_v2.py builds the new design: three maple frame layers (15 mm) with
    an inner ring, outer ring and three bridges; the two LED layers, white
    ring, face and C from v1; and a black back held by six M4 screws into
    12 mm wood inserts. All components mount on the back: buttons facing out
    through square holes, the 18650 holder in a stacked-acrylic box clamped
    by four M3 screws, and a roughed-in electronics pod whose USB-C ports
    face the hand hole. Cut files, an insert test coupon, the pod envelope
    and the 3D board source live in cad/v2/.
    [acrylic-10mm-white-ring.dxf, acrylic-3mm-black-back.dxf, acrylic-3mm-black-battery-box-floor.dxf, acrylic-3mm-black-battery-box-ring-x2.dxf, acrylic-3mm-black-face.dxf, acrylic-3mm-white-c.dxf, back.stl, battery_box.stl]
2026-10-31 Bench strip: first 6 LEDs are the outer ring, the rest the inner C
    disc-1-bench now splits the 11-LED test strip like the real disc, ring
    first, so black's ring on/off can be tried with the C still lit. Black tap
    is back to ending an effect, or toggling the ring when already steady.
2026-10-31 Add battery box, electronics pod, face plate and LED path to disc v2
    Battery: holder in a stacked black acrylic box (two rings + floor)
    clamped by four M3 screws, with its own build board. Electronics pod:
    TP4056 and ESP32-C3 at the hand hole, MT3608 behind, in a 1 mm locator
    under a black hold-down held by four M2 screws, closed off by a cemented
    3 mm face plate with openings only for the USB-C ports. LED path: C strip
    input drops to an in-line 3-pin connector on the back; a jumper links
    the C to the outer strip. Wire notches moved to the bottom frame layer.
    Frame is now three layers for the 12 mm inserts.
    [acrylic-3mm-black-back.dxf, acrylic-3mm-black-pod-face-plate.dxf, acrylic-3mm-black-pod-holddown.dxf, acrylic-thin-pod-locator.dxf, back.stl, back_piece.stl, box_screws.stl, cell.stl]
